anjakuchenbecker/mobile_smart_home_diy_camper_van/README.md

# "Mobile Smart Home" for our DIY Camper Van

With this repo I provide my concepts and some code snippets (example sketches) about our DIY camper van (Mercedes Sprinter W906; L4H2) that I will turn into a "Mobile Smart Home" with an Arduino Mega and a bunch of electronic components.
Besides the Arduino Mega I plan in addition to install a Raspberry PI with a nice touch screen which communicates with the Arduino Mega.

Check out also our [DIY Selbstausbau Blog & Vlog Camper Renntransporter](https://trackdates.de/howto/renntransporter/).

Example sketches can be found here: [Example Sketches](#example-sketches) 

## Table of Contents

- [Project Status](#project-status)
- [Planning and Overview](#planning-and-overview)
- [Features](#features)
- [Integration of the following hardware components](#integration-of-the-following-hardware-components)
- [Project Management](#project-management)
- [Overall Prototyping Status](#overall-prototyping-status)
- [Control Units](#control-units)
  - [Prototype Control Unit Sideboard](#prototype-control-unit-sideboard)
  - [Prototype Control Unit Bedroom](#prototype-control-unit-bedroom)
- [Storyboard Display](#storyboard-display)
  - [Display Implementation](#display-implementation)
- [Lighting Control Concept](#lighting-control-concept)
- [Example Sketches](#example-sketches)

## Project Status

**October 2021:**
Even if the final installation has been completed, I took a small improvement with respect to the illumination of the control units. 

I first used a round type red LED, but this wasn't bright enough. Reading the labels in the dark wasn't easy... so I switched over to a very, very small cold white SMD LED (mounting form 0805). Now I'm entirely happy! Have a look at the result:

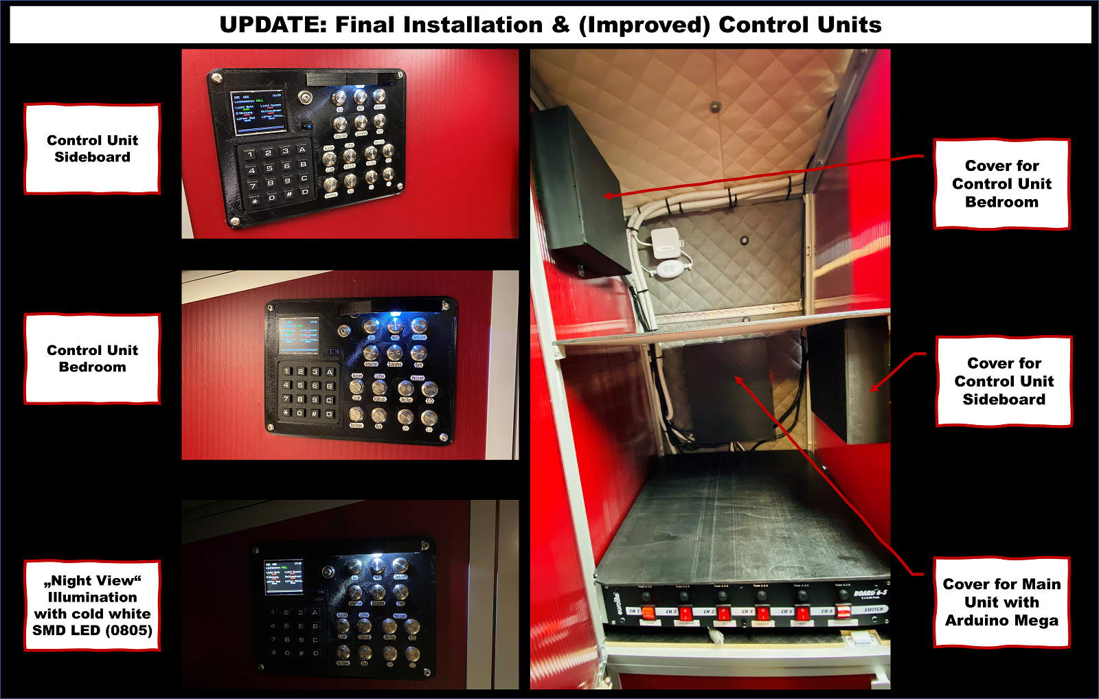
[picture p1: docs/mobile_smart_home_diy_camper_van_update_final_installation_and_improved_control_units.png]


**September 2021:**
Final installation is completed! I've build the final units (yes, a lot of more soldering and special thanks to our 3D Printer), installed all electronis components and wires (didn't measure the entire wire length, but this step took several weekends for completion) and adapted my code. 

Especially, handling the well-known issue with the distance sensors, when there is a lot of sun light. But with a little bit of math and statistics: now it works like a charm ;-)

More details are coming, we'll create a dedicated youtube video about the making of and the final installation and units.
For now, here is an impression about the final installation and the look of the final control units:

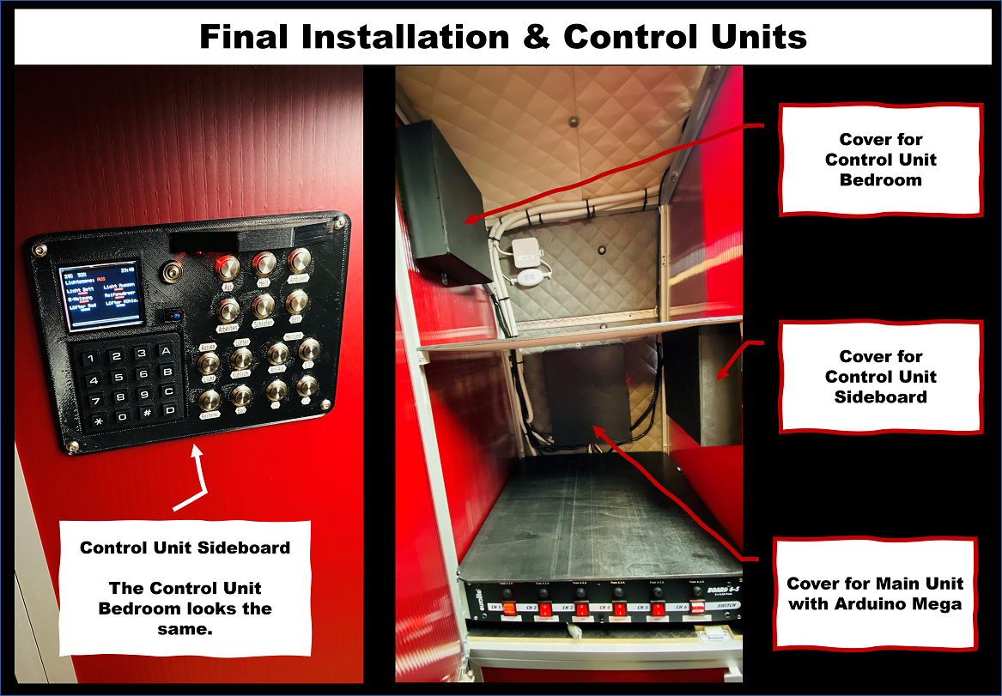
[picture p2: docs/mobile_smart_home_diy_camper_van_final_installation_and_control_units.png]


**June 2021:**
Prototyping is completed! I've soldered a lot, physically installed all of the electronic components and wrote over 4500 lines of code. Next step is to transform this prototype setup into final units, which can I install into our Sprinter.

## Planning and Overview

I've planned to install a bunch of components in the different areas within our Sprinter

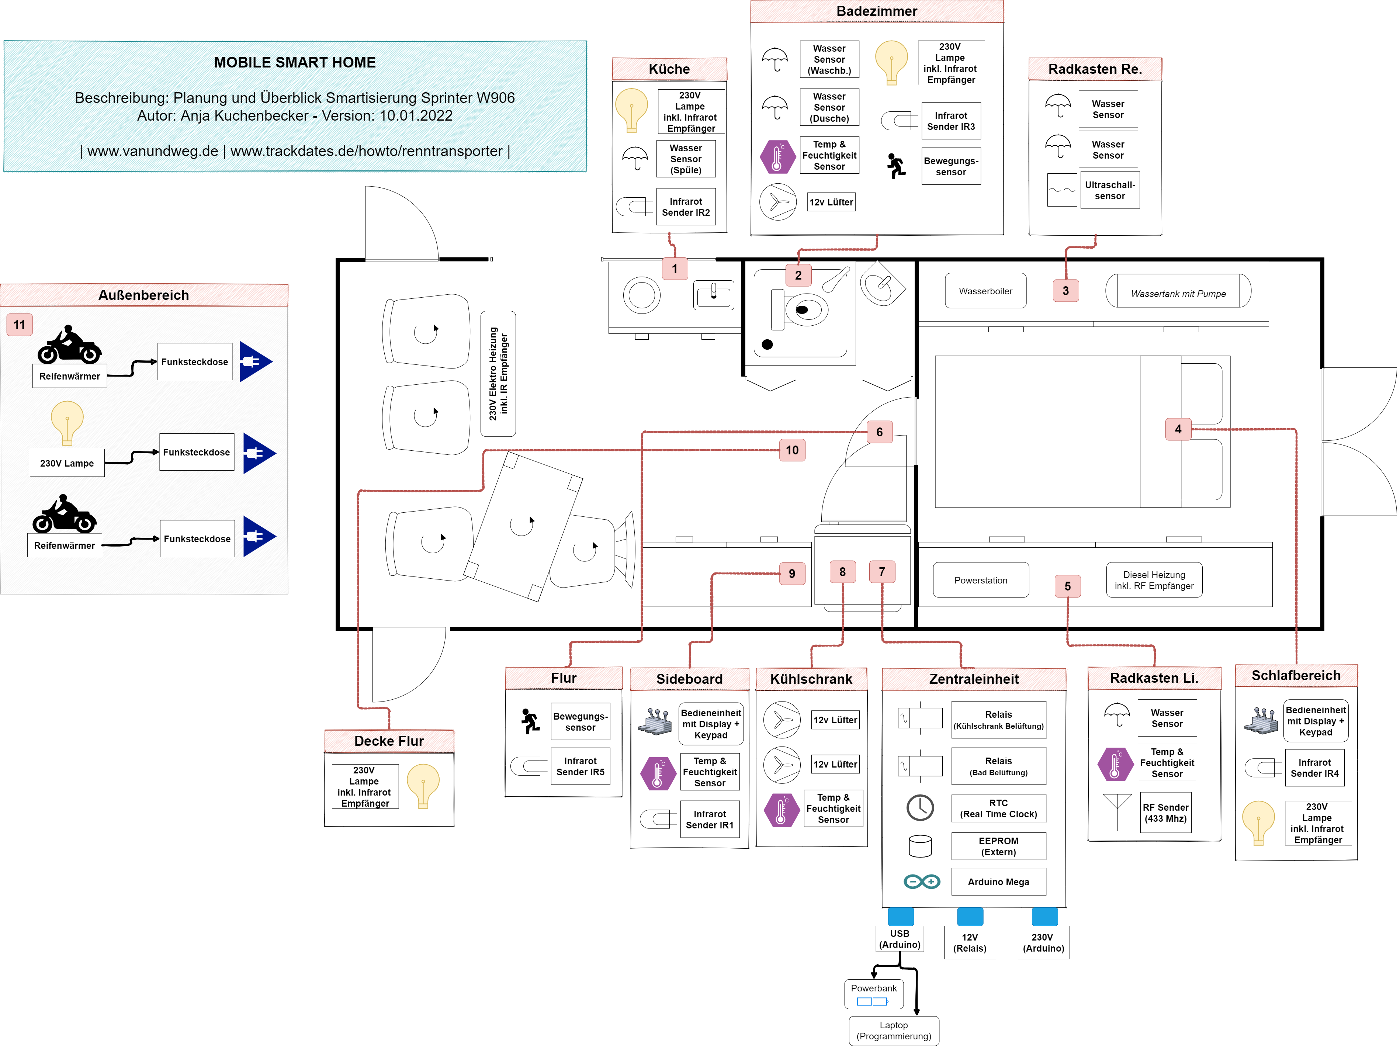
[picture p3: docs/mobile_smart_home_diy_camper_van_planning_overview.png]
Planning and Overview Diagram


## Features

The main features of self-made "Mobile Smart Home" solution are as follows

- Creation of two control units, which replace the handling different IR / RF vendor remote controls. One within the sideboard area the other one within the bedroom area, which offers the following means
  - Turn outside light on or off
  - Turn tire warmers on or off
  - Activation of five different light scenes (please refer to [Lighting Control Concept](#lighting-control-concept))
    - "Off": Turns all lights off (motion based triggered bathroom light excluded)
    - "Bright": Turns all lights on with maximum brightness level (motion based triggered bathroom light excluded)
    - "Ambient": Turns all lights on with low brightness level, orange light (motion based triggered bathroom light excluded)
    - "Work": Turns all lights on with medium brightness level, white light
    - "Sleep": Activates motion detector in corridor area. When motion is detected one light is activated in red color on lowest brightness level and the bathroom light is switched to red color in lowest brightness level when within the bathroom area a motion is detected.
  - Turn bedroom light on or off (separately despite the current enabled light scene)
  - Switch between electric heater and diesel heater control
  - Turn (electric or diesel) heater on or off
  - Increase or decrease of (electric or diesel) heater temperature
  - Touch area to switch between the different display states (please refer to [Storyboard Display](#storyboard-display))
    - [Default Screen](#default-screen-implementation)
    - [Water ingress status Screen](#water-ingress-status-screen-implementation)
    - [Climate status Screen](#climate-status-screen-implementation)
    - [Tire Warmers Timer](#tire-warmers-timer-implementation)
    - [Time and Date Setting](#time-and-date-setting-implementation)
    - [System Settings](#system-settings-implementation)
      - [Light Duration Configuration](#light-duration-configuration-implementation)
      - [Fridge Fan Temperature Threshold Configuration](#fridge-fan-temperature-threshold-configuration-implementation)
      - [Bathroom Fan Humidity Threshold Configuration](#bathroom-fan-humidity-threshold-configuration-implementation)
      - [Water Sensor Threshold Configuration](#water-sensor-threshold-configuration-implementation)
      - [Sideboard Distance Threshold Configuration](#sideboard-distance-threshold-configuration-implementation)
      - [Sideboard Touch Threshold Configuration](#sideboard-touch-threshold-configuration-implementation)
      - [Bed Distance Threshold Configuration](#bed-distance-threshold-configuration-implementation)
      - [Bed Touch Threshold Configuration](#bed-touch-threshold-configuration-implementation)
  - Control unit is illuminated automatically as well as display is turned on for a specific duration in case of your hand comes near the control unit
  - Display is turned on for a specific duration in case of touch or button push is detected
  - You can set a timer when the tire warmers should be turned on (only via control unit sideboard)
  - You can set date and time (only via control unit sideboard)
- Bathroom light turns on automatically for a specific duration in case of motion is detected (color and brightness level depends on currently activated light scene)
- Bathroom fan turns on automatically in case of specific humidity threshold overrun is detected
  - Behavior can be overruled by permanently on and off mode
- Fans located in fridge closet turn on automatically in case of specific temperature threshold overrun is detected
  - Behavior can be overruled by permanently on and off mode
- Water tank level monitoring
- Water ingress level monitoring
- Temperature and humidity monitoring
- Change of system configuration parameters
  - LED and background light duration of control units
  - Temperature threshold for fridge fans
  - Humidity threshold for bathroom fan
  - Water ingress threshold for water sensors
  - Distance recognition threshold for sideboard control unit
  - Touch recognition threshold for sideboard control unit 
  - Distance recognition threshold for bed control unit
  - Touch recognition threshold for bed control unit 
- Permanently storage of system configuration parameters
- Pluggable main unit ("Zentraleinheit"): One the one hand the main unit can be easily put out during winter time, when our Sprinter is not in use. On the other hand it can be easily put in temporary, also during winter time, to check if there are no issues (e.g., water ingress) operated with the support of a USB power bank.

## Integration of the following hardware components 

Total: 116 components
- Arduino Mega 2560 compatible microcontroller board (1 piece; ELEGOO Mega2560 R3)
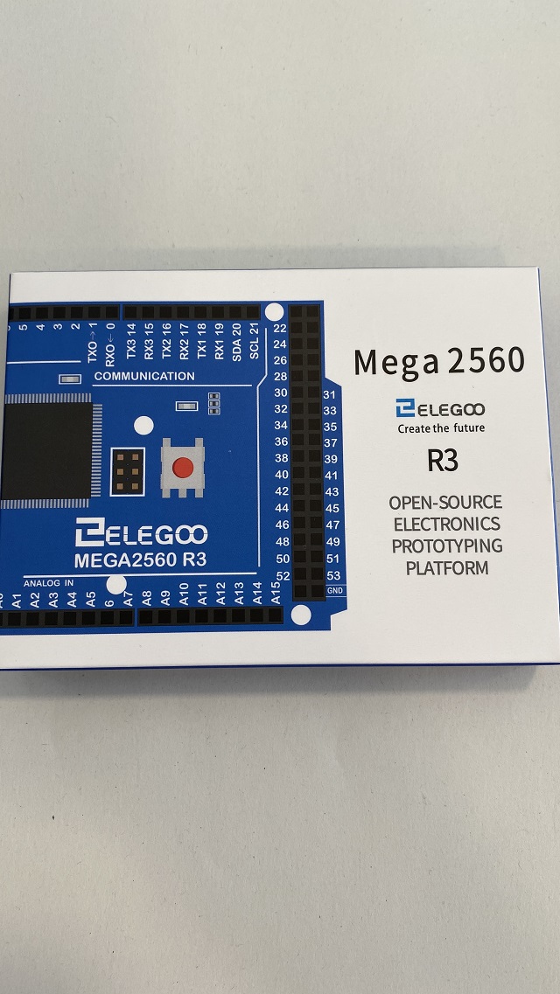
[picture p4: components/elegoo_mega_2560_r3.jpg]
  -   
- Screw / Terminal Block Shield Board Kit For ArduinoMEGA-2560 R3
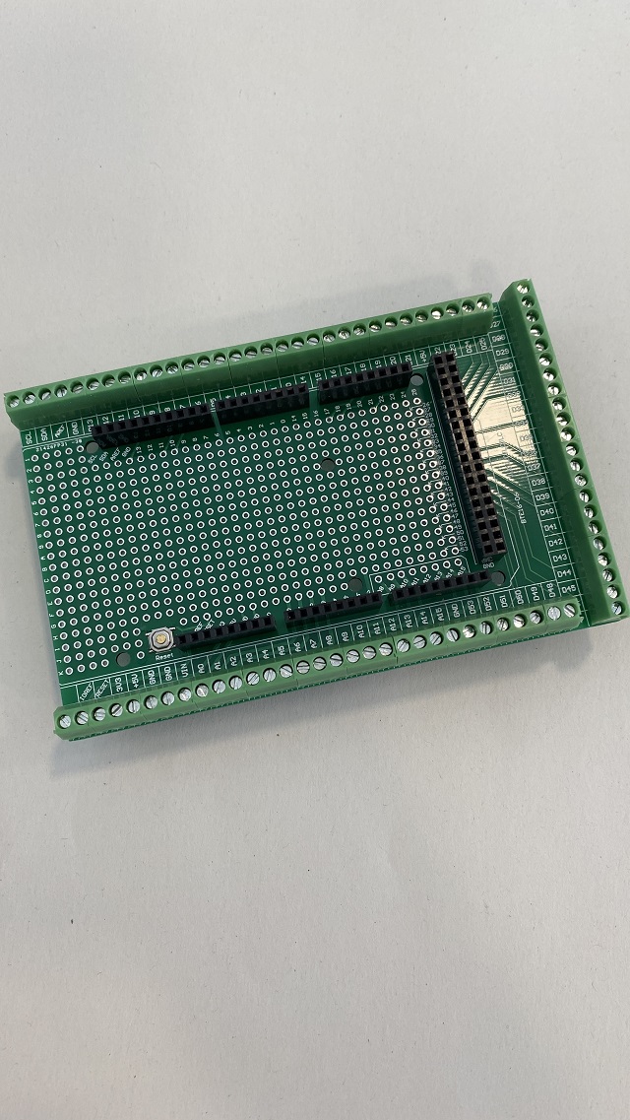
[picture p5: components/screw_terminal_block_shield_board_kit_arduino_mega.jpg]
  -   
- 230V lights (4 pieces) with IR remote control from different vendors (e.g., iDual)
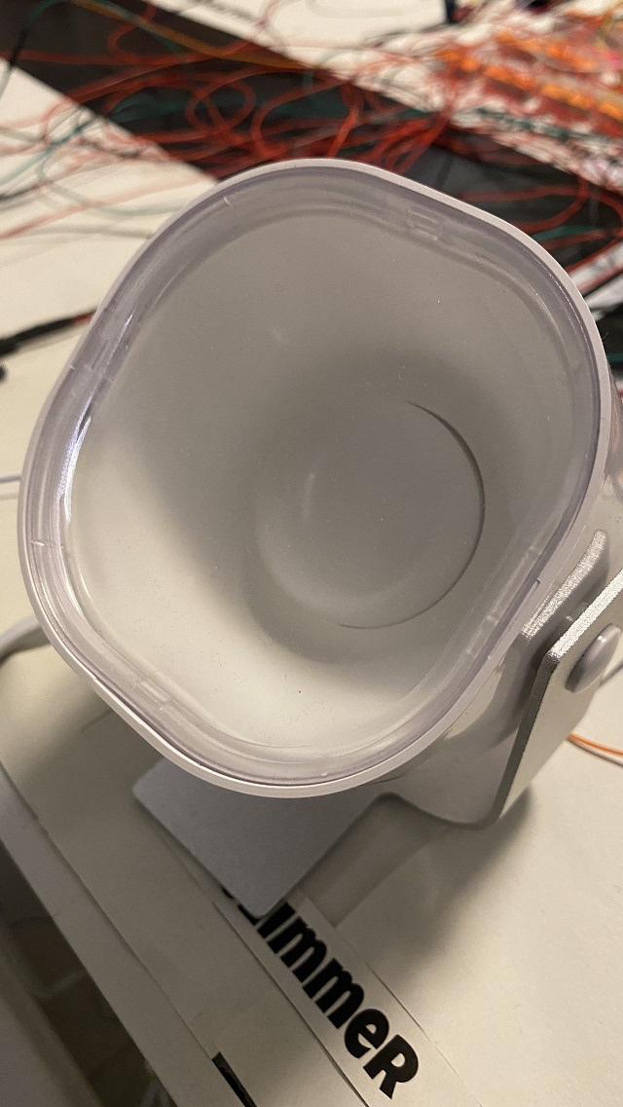
[picture p6: components/iDual_led_projektor_eek_front.jpg]
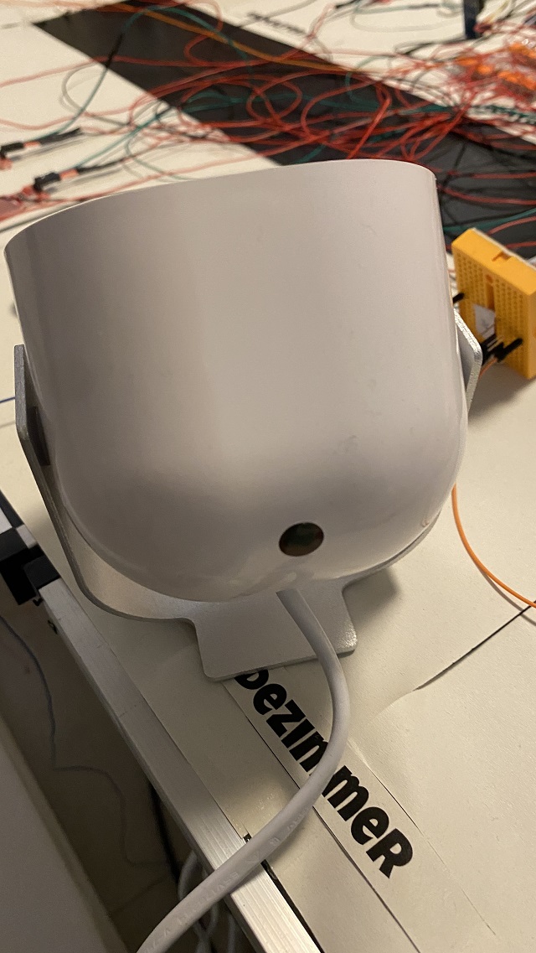
[picture p7: components/iDual_led_projektor_eek_back.jpg]
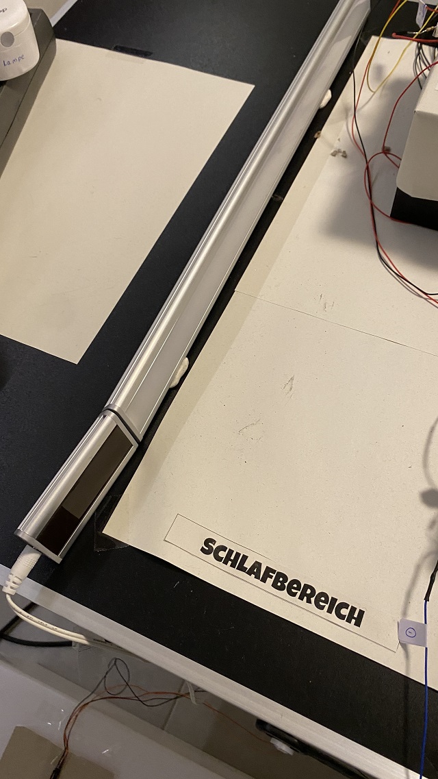
[picture p8: components/iDual_led_udo.jpg]
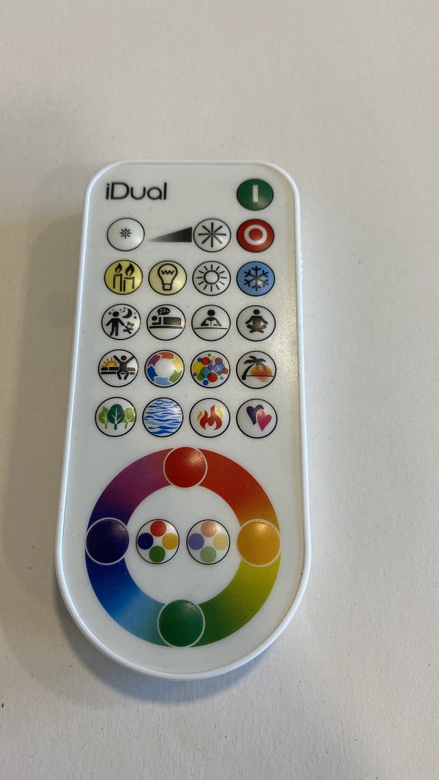
[picture p9: components/iDual_remote_control.jpg]
  - 
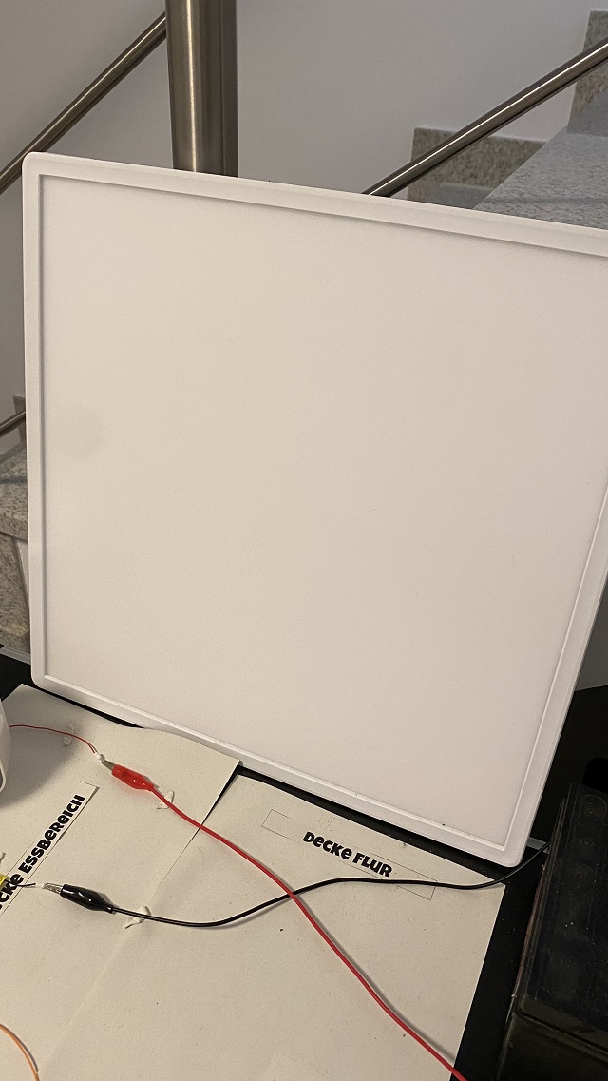
[picture p10: components/LED_ceiling_light.jpg]
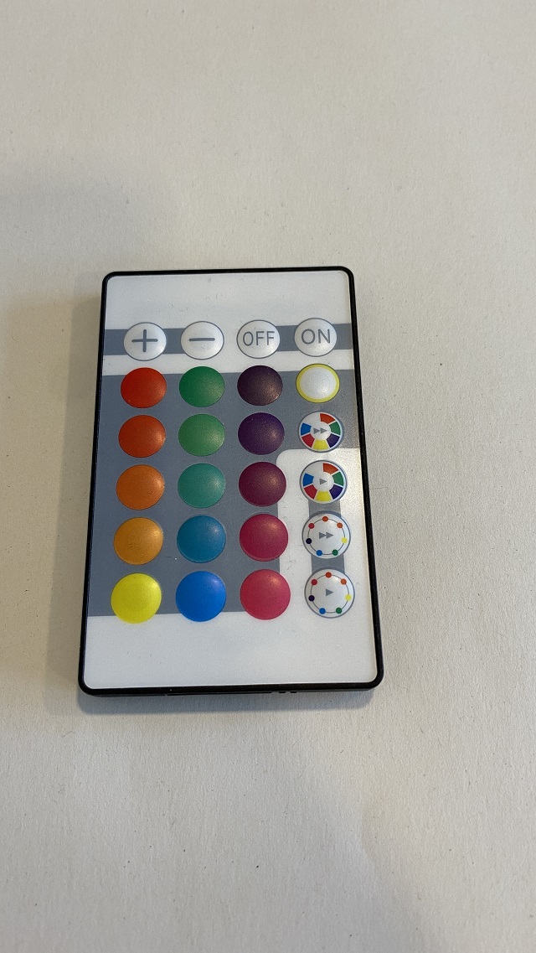
[picture p11: components/LED_ceiling_light_remote_control.jpg]
  - 
- 230V electric heater with IR remote control
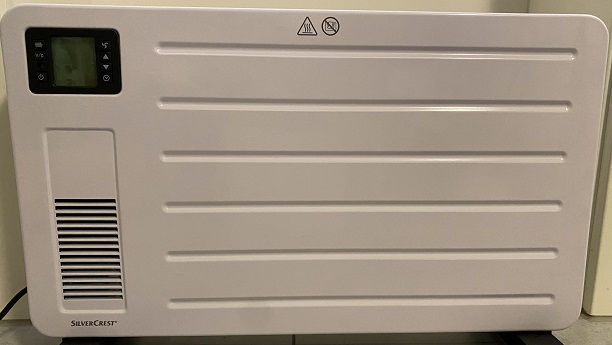
[picture p12: components/230_v_electric heater.jpg]
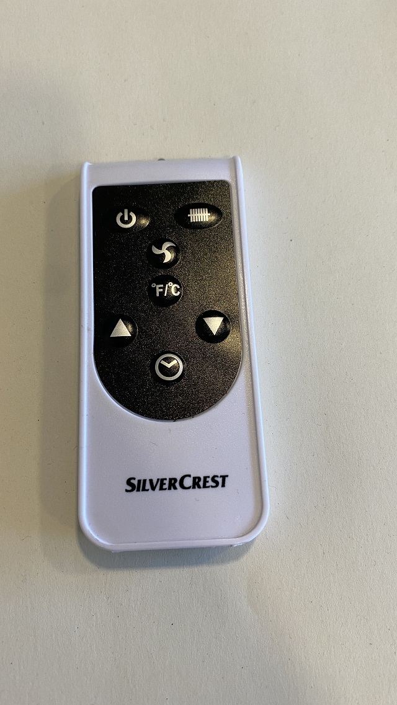
[picture p13: components/230_v_electric heater_remote_control.jpg]
  -   
- 12V diesel heater with RF remote control
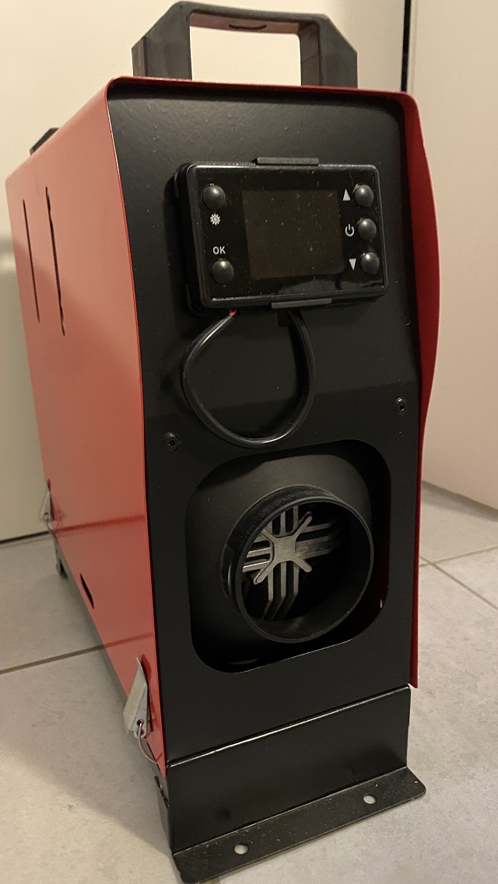
[picture p14: components/12_v_diesel_heater.jpg]
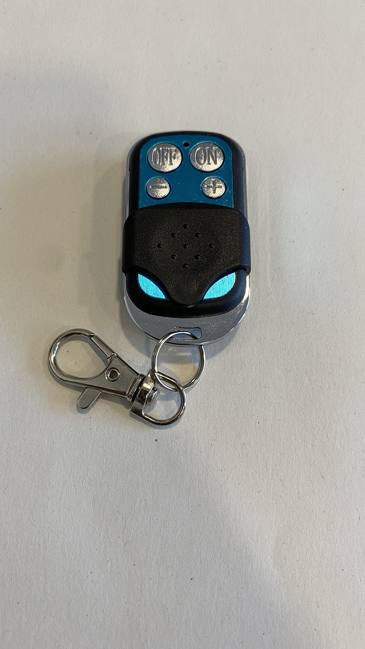
[picture p15: components/12_v_diesel_heater_remote_control.jpg]
  -   
- 230V RF sockets (2 pieces) with RF remote control
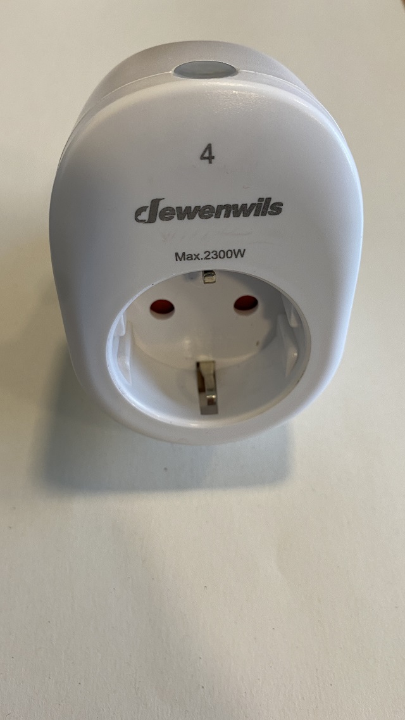
[picture p16: components/rf_plug_socket.jpg]
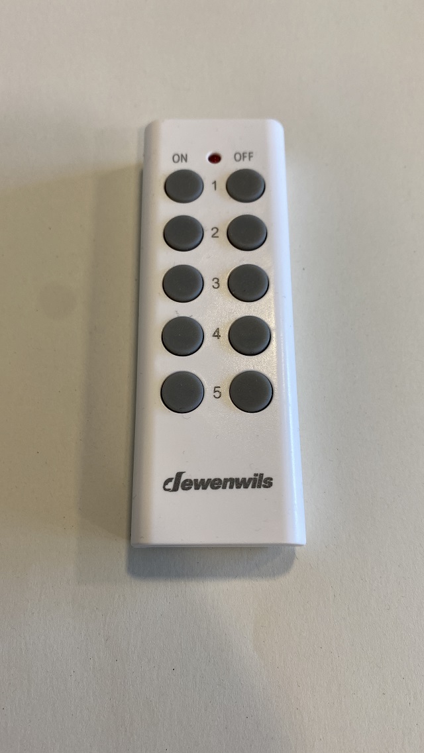
[picture p17: components/rf_plug_socket_remote_control.jpg]
  -  
- 80x80x25mm fan (1 piece; 12V, 76,4m^3/h, 38dBA)
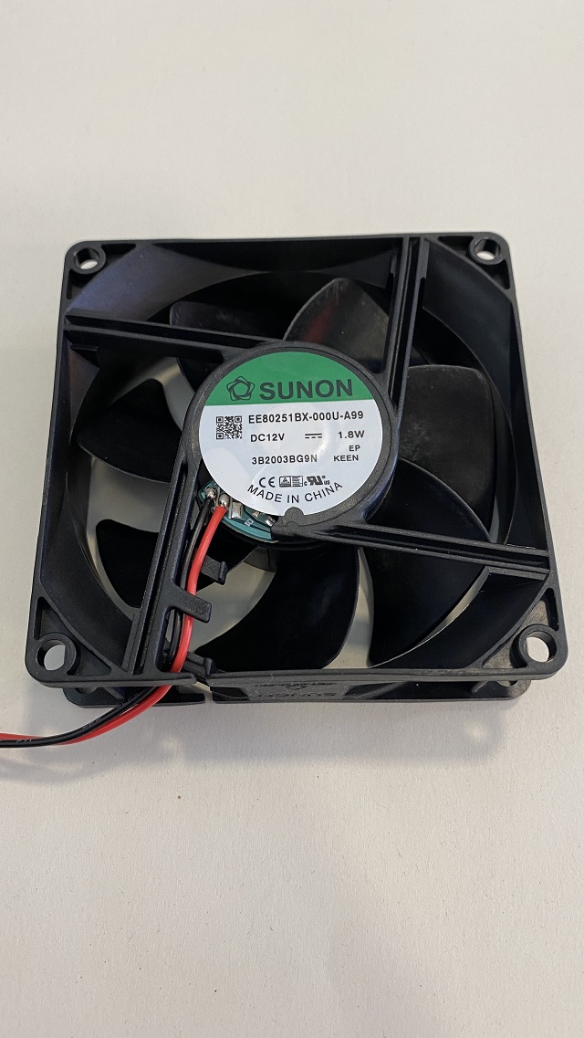
[picture p18: components/80_80_25_fan.jpg]
  -   
- 120x120x25mm fans (2 pieces; 12V, 127,3m^3/h, 34dBA)
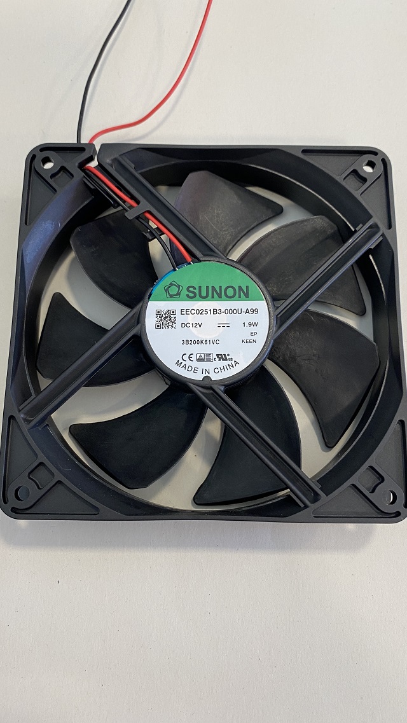
[picture p19: components/120_120_25_fan.jpg]
  -    
- Water Sensors (6 pieces; SE045)
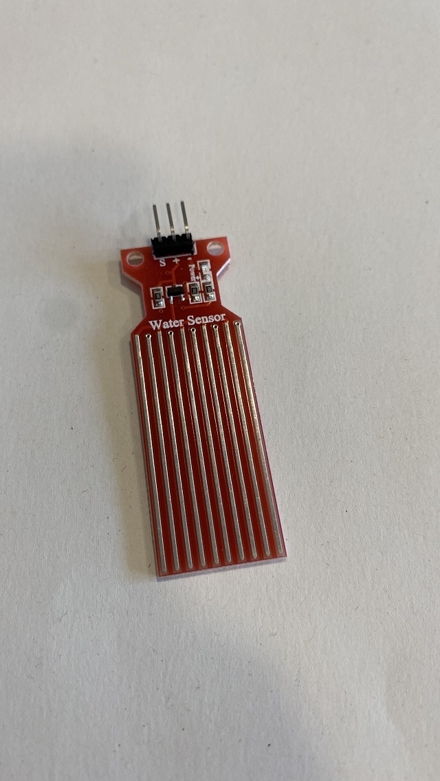
[picture p20: components/water_sensor_SE045.jpg]
  - 
- Ultrasonic sensor (1 piece; HC-SR04)
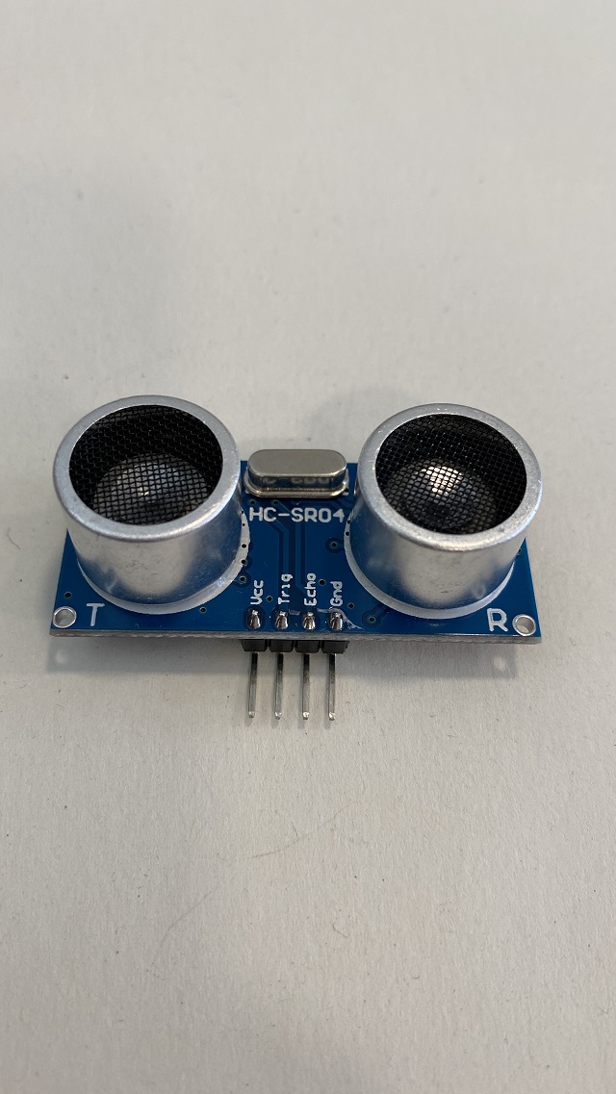
[picture p21: components/ultrasonic_sensor_hc_sr04.jpg]
  -   
- IR-Emitter (5 pieces; TSAL 6200 IR-Emitter 940nm)
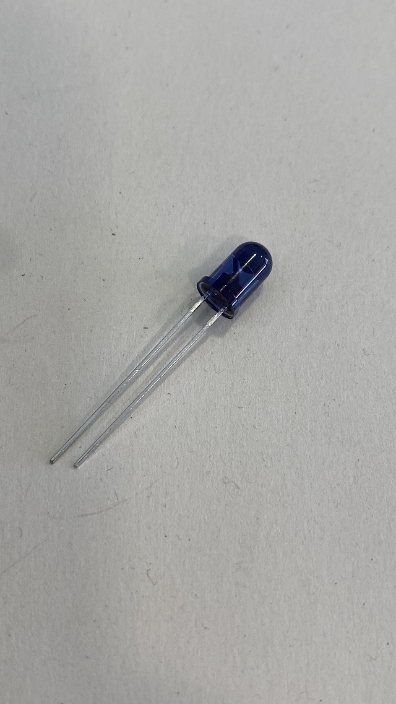
[picture p22: components/tsal_6200ir_emitter_940_nm.jpg]
  -  
- Motion Sensors (2 pieces; HC-SR501)
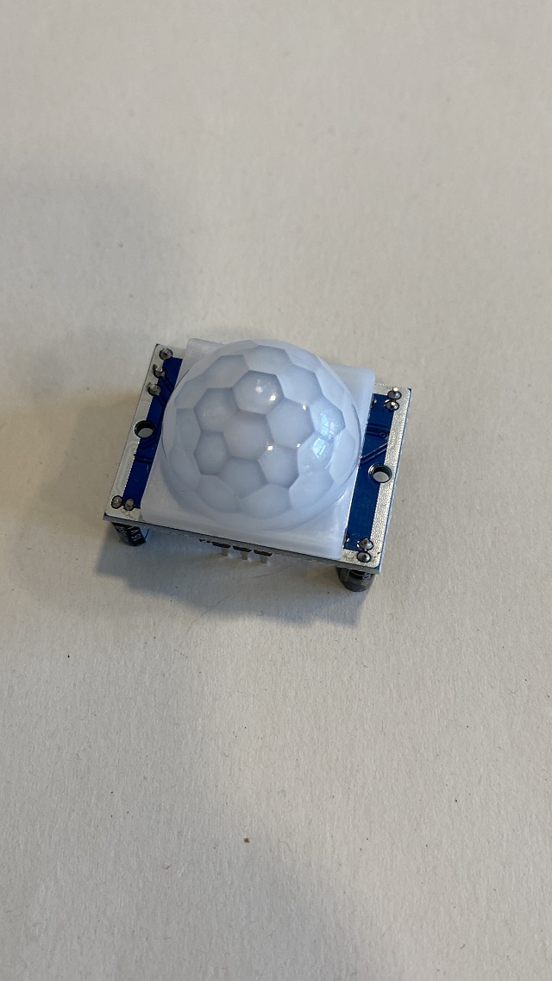
[picture p23: components/motion_sensor_HC-SR501_front.jpg]
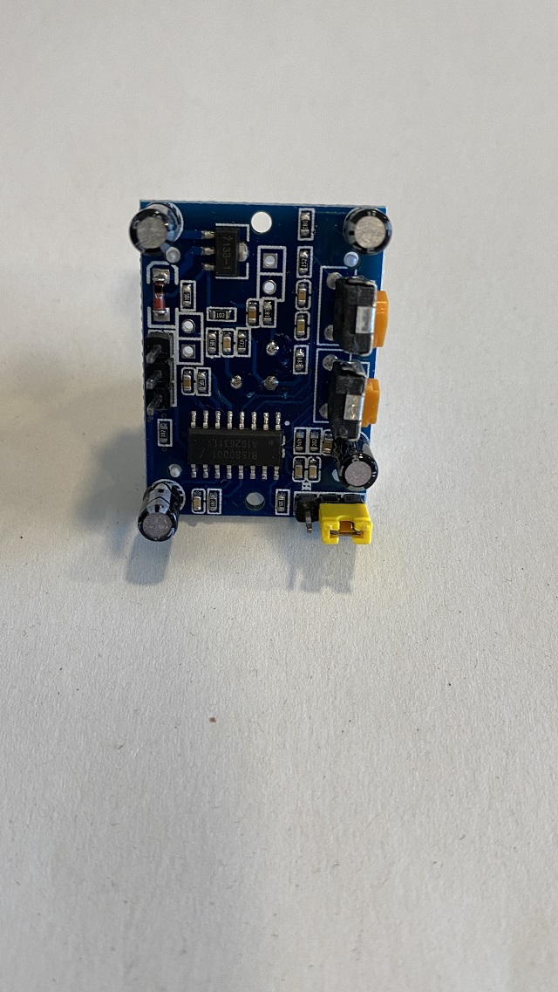
[picture p24: components/motion_sensor_HC-SR501_back.jpg]
  - 
- Temperature & Humidity Sensors (4 pieces; DHT22)
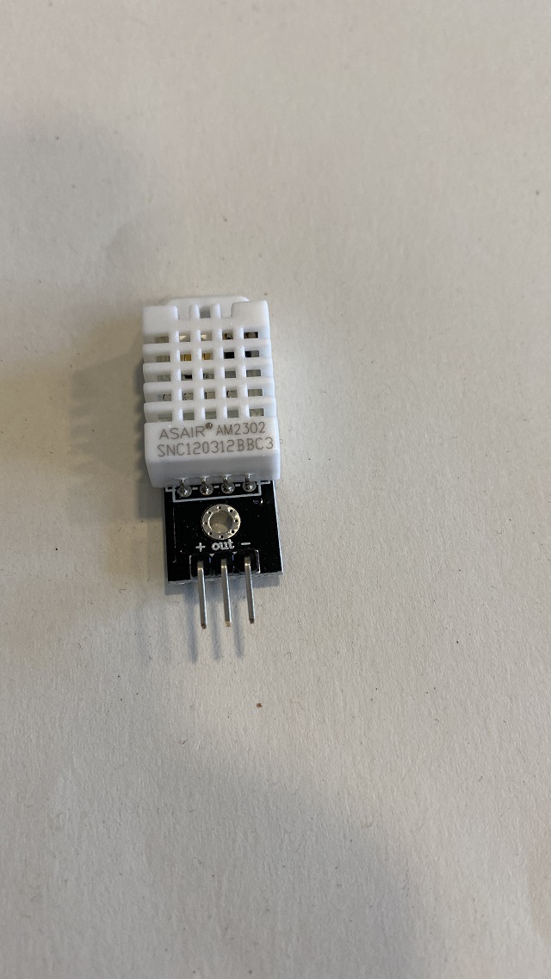
[picture p25: components/temperature_humidity_sensor_DHT22.jpg]
  -  
- TFT Displays (2 pieces; 1.8 Zoll SPI ST7735 TFT Display 128 x 160 Pixel)
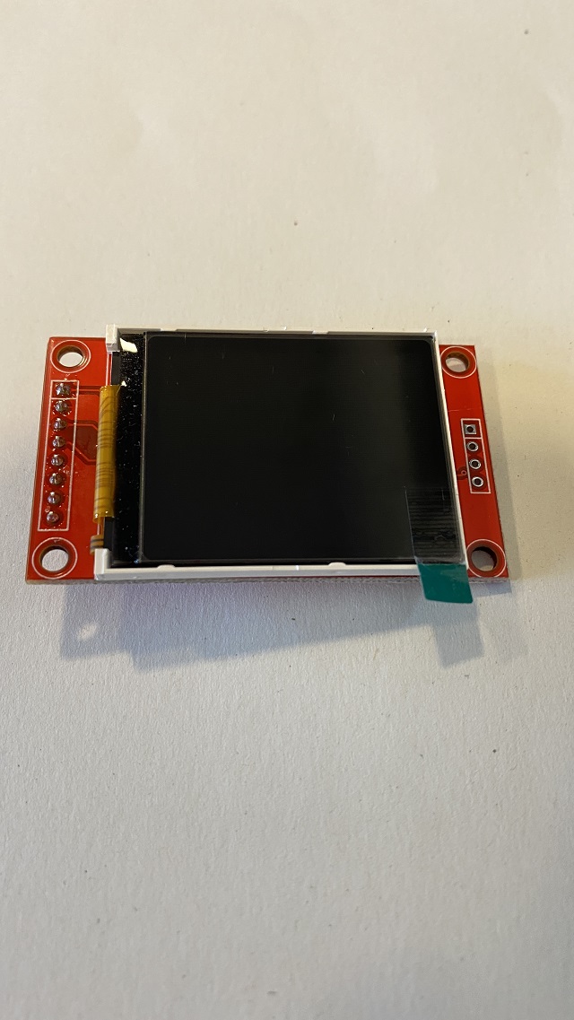
[picture p26: components/1-8_SPI_TFT_Display_ST7735_128x160_front.jpg]
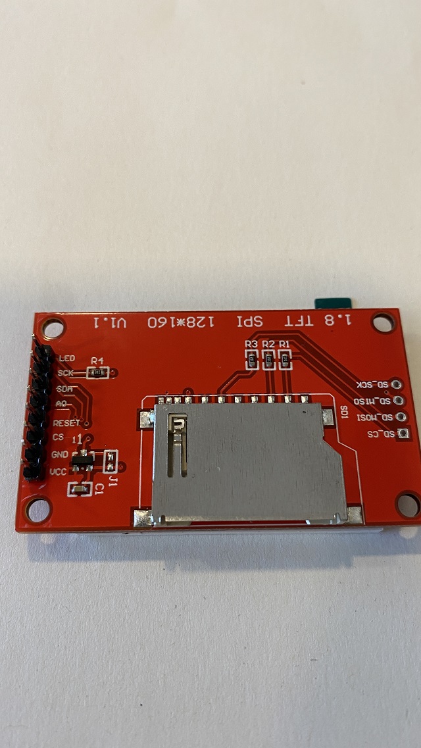
[picture p27: components/1-8_SPI_TFT_Display_ST7735_128x160_back.jpg]
  -   
- Line Follower IR Sensor (2 pieces; TCRT5000)
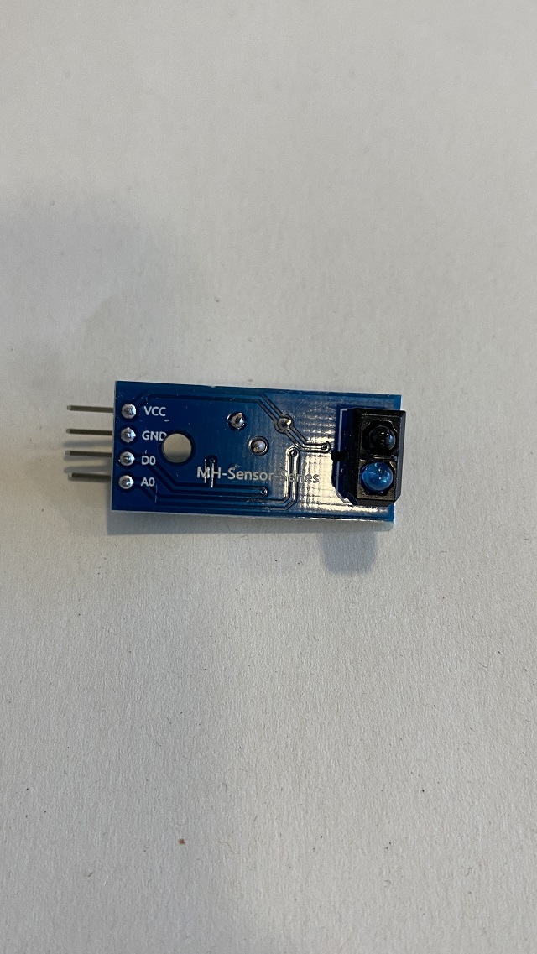
[picture p28: components/line_follower_ir_sensor_front.jpg]
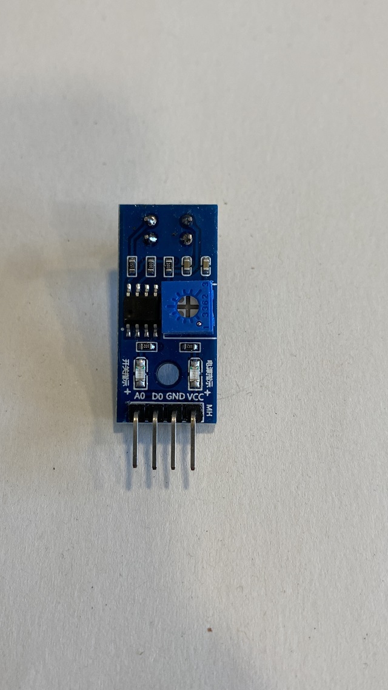
[picture p29: components/line_follower_ir_sensor_back.jpg]
  -    
- Shift registers (4 pieces; 74HC165)
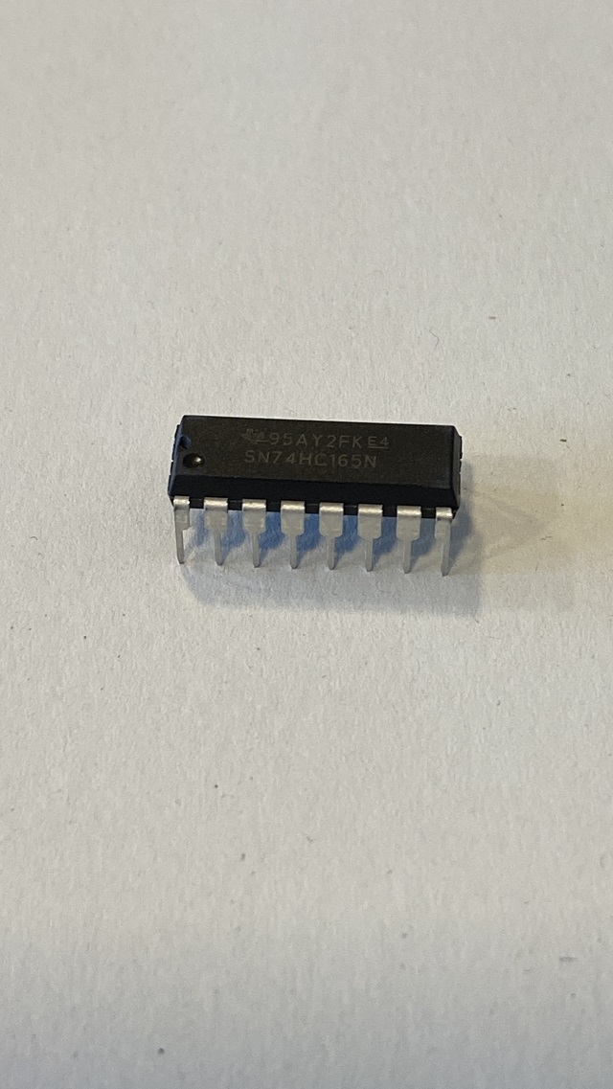
[picture p30: components/74HC165_shift_register.jpg]
  -  
- Real Time Clock (1 piece; DS3231)
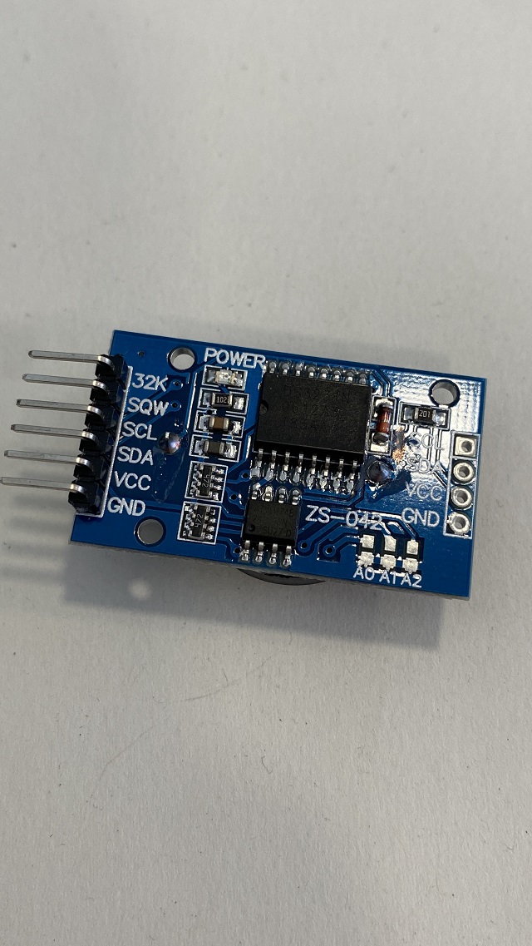
[picture p31: components/real_time_clock_rtc_DS3231_front.jpg]
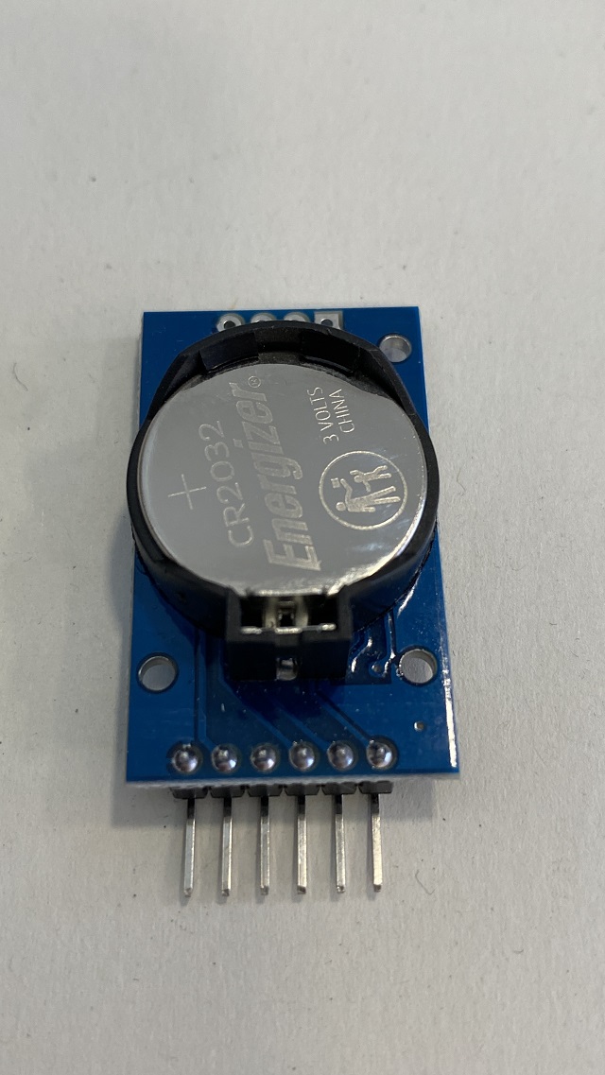
[picture p32: components/real_time_clock_rtc_DS3231_back.jpg]
  -  
- Relais Module (1 piece; 4-Relais Modul 5V)
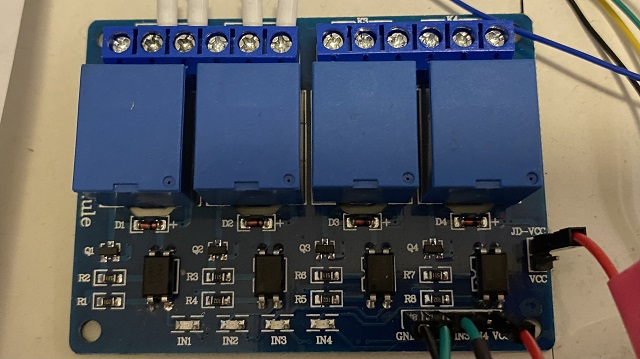
[picture p33: components/4_relais-modul 5_v.jpg]
  -  
- NPN-Transistor (1 piece; PN2222)
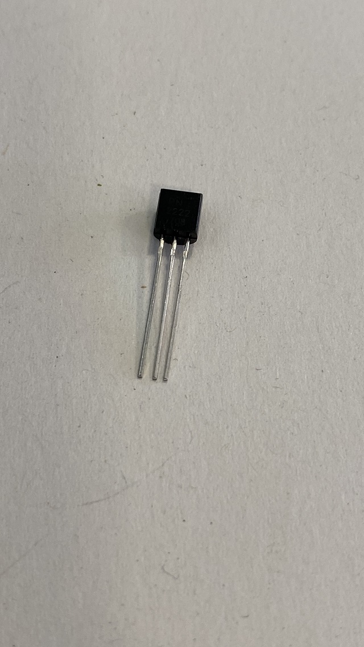
[picture p34: components/npn-transistor_pn2222.jpg]
  -  
- External EEPROM Module (1 piece; AT24C256 I2C Interface EEPROM)
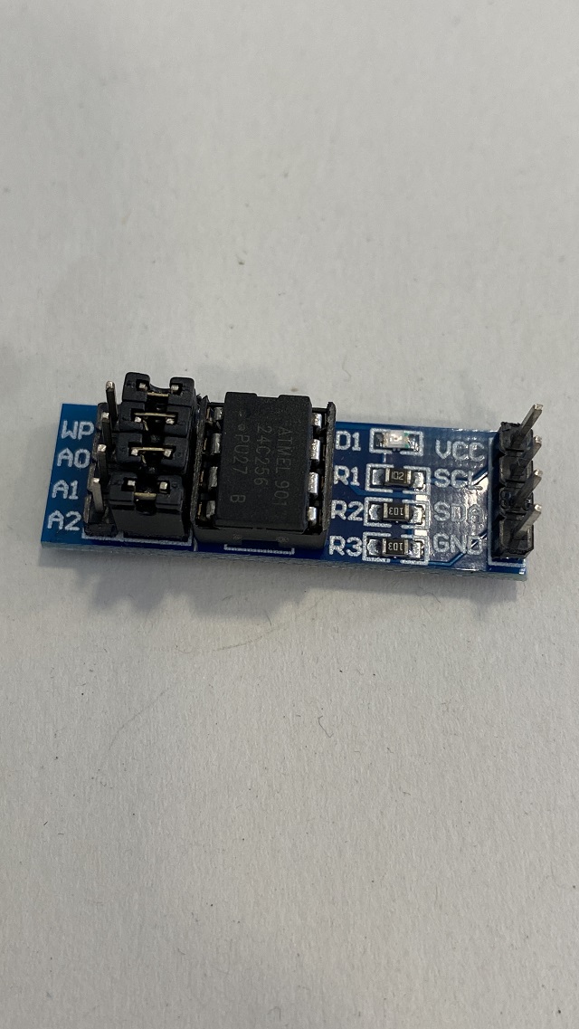
[picture p35: components/external_eeprom_at24c256_i2c_interface_eeprom.jpg]
  -  
- RF 433 MHz Transmitter (1 piece; H34A)
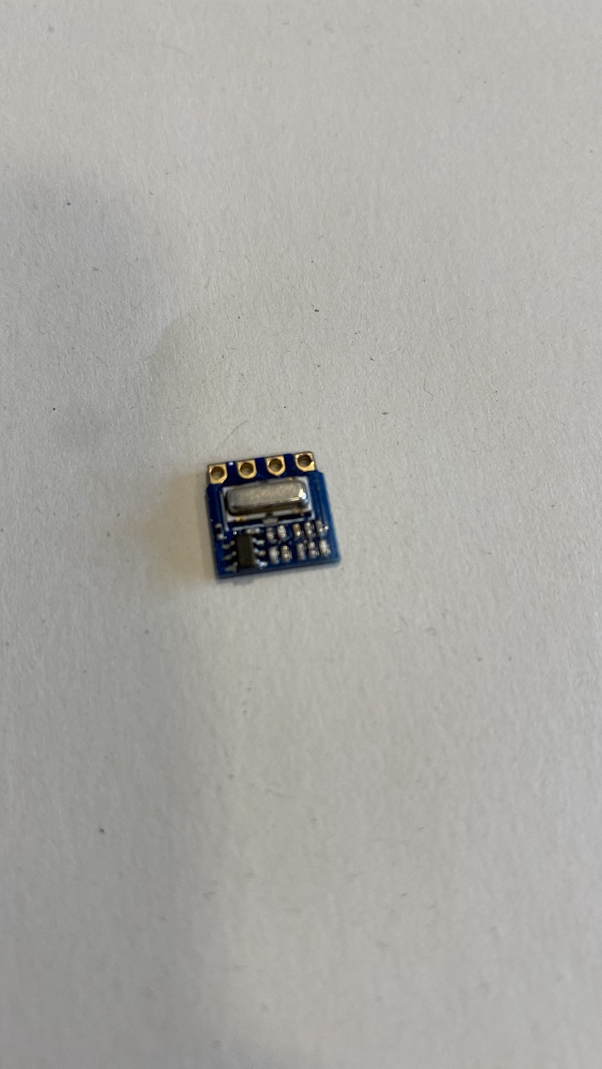
[picture p36: components/rf_433_mhz_transmitter_H34A_front.jpg]
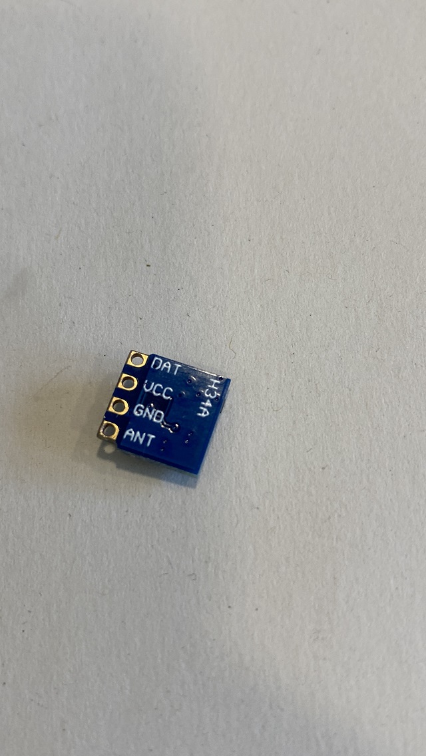
[picture p37: components/rf_433_mhz_transmitter_H34A_back.jpg]
  -   
- Momentary Push Buttons (28 pieces; 12mm)
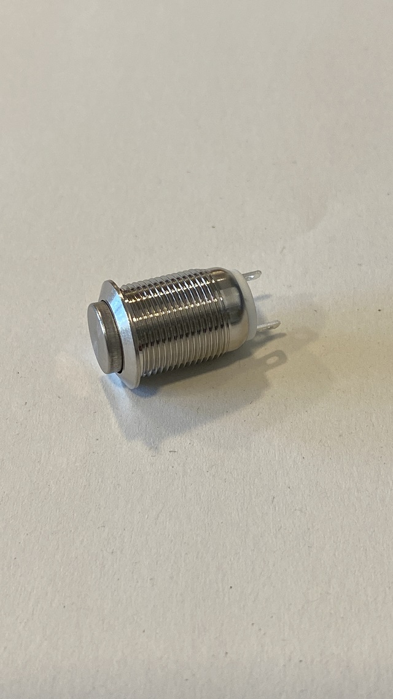
[picture p38: components/Momentary_Push_Button_12mm.jpg]
  -  
- 4x4 Matrix Keypad (2 pieces)
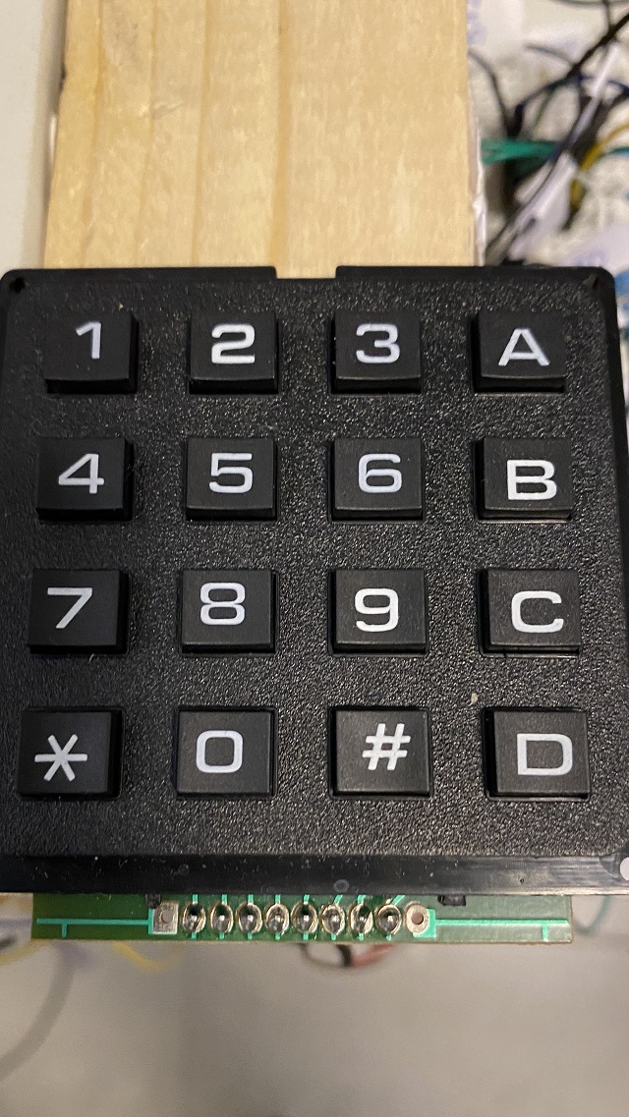
[picture p39: components/Matrix_Keypad_4x4.jpg]
  -  
- SMD LED cold white (2 pieces; mounting form 0805)
- Different resistors

## Project Management

For the management of this project I have set up a trello board (Kamil acts as tester as well as a requirements stakeholder like me):

Please note that I've blackened most of the story cards!

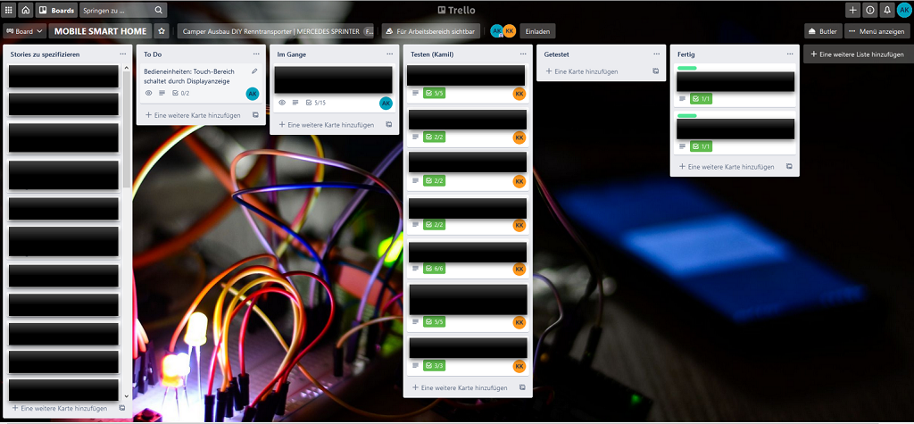
[picture p40: docs/mobile_smart_home_diy_camper_van_trello_board.png]
 

I have break down all requirements / stuff I have to build and implement in the course of this project into stories, here is an example story:

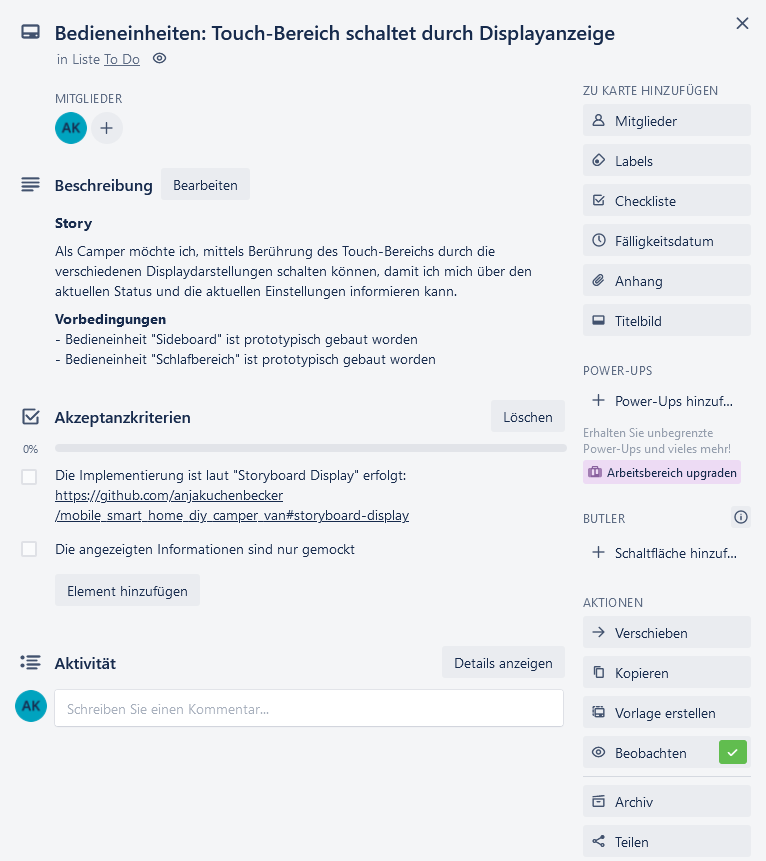
[picture p41: docs/mobile_smart_home_diy_camper_van_story_detail.png]
 

## Overall Prototyping Status

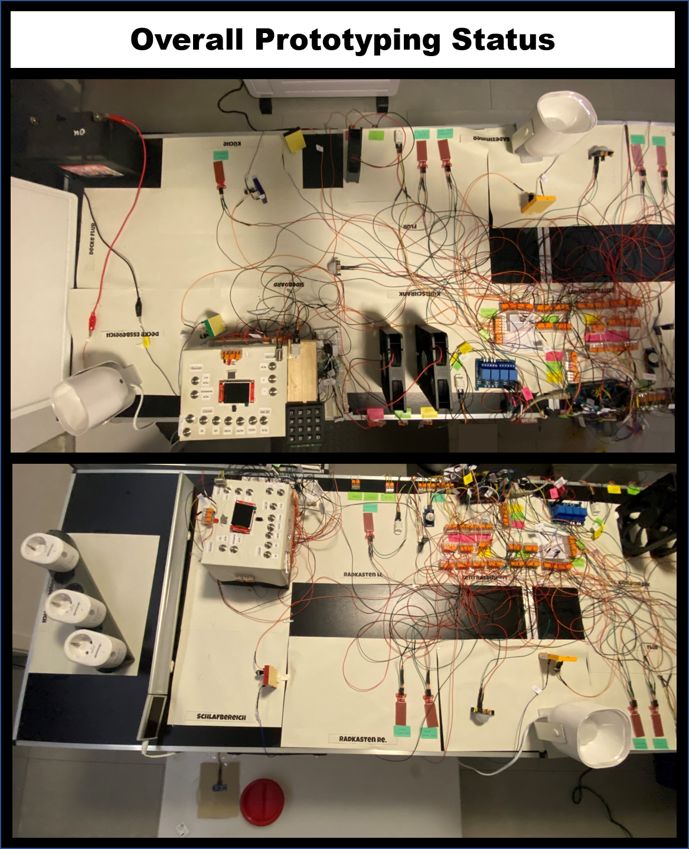
[picture p42: docs/mobile_smart_home_diy_camper_van_overall_prototyping_status.png]
 

## Control Units

I created a functional concept for the control units, that I plan to build for our Sprinter.

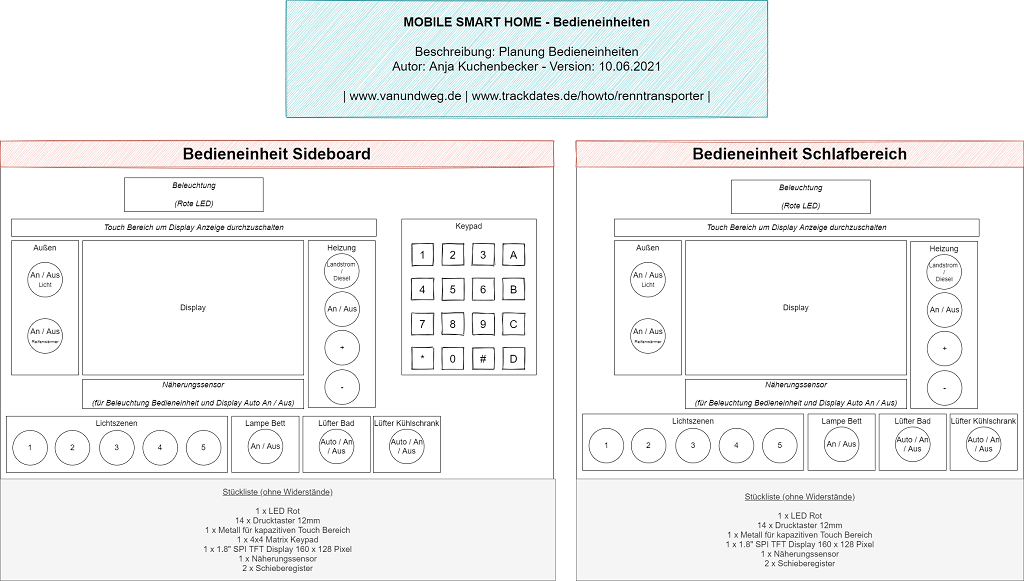
[picture p43: docs/mobile_smart_home_diy_camper_van_control_units.png]
Control Units Diagram


### Prototype Control Unit Sideboard

Current Prototype (only for testing purposes) and the creation process behind:

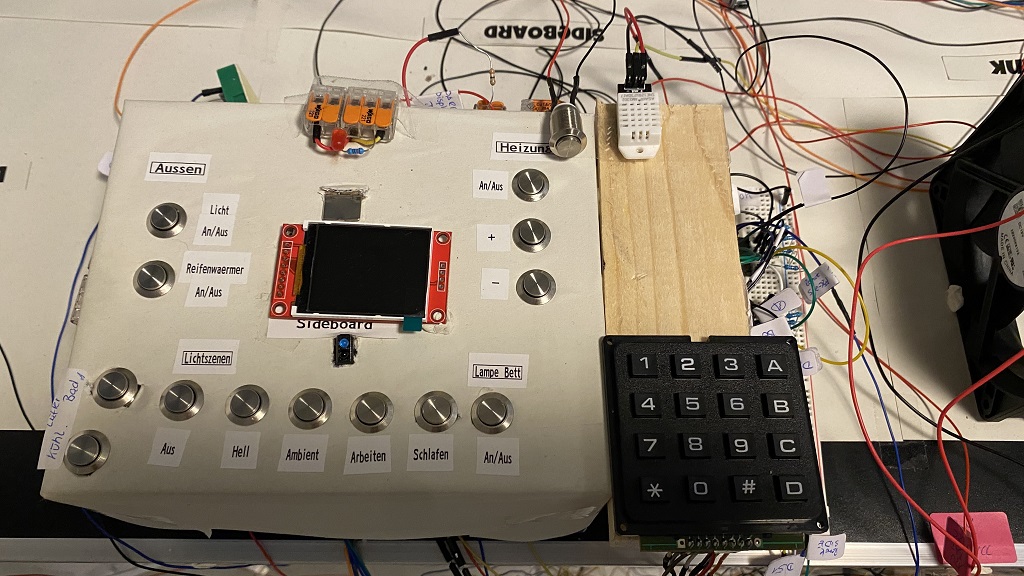
[picture p44: docs/mobile_smart_home_diy_camper_van_prototype_control_unit_sideboard.jpg]
 

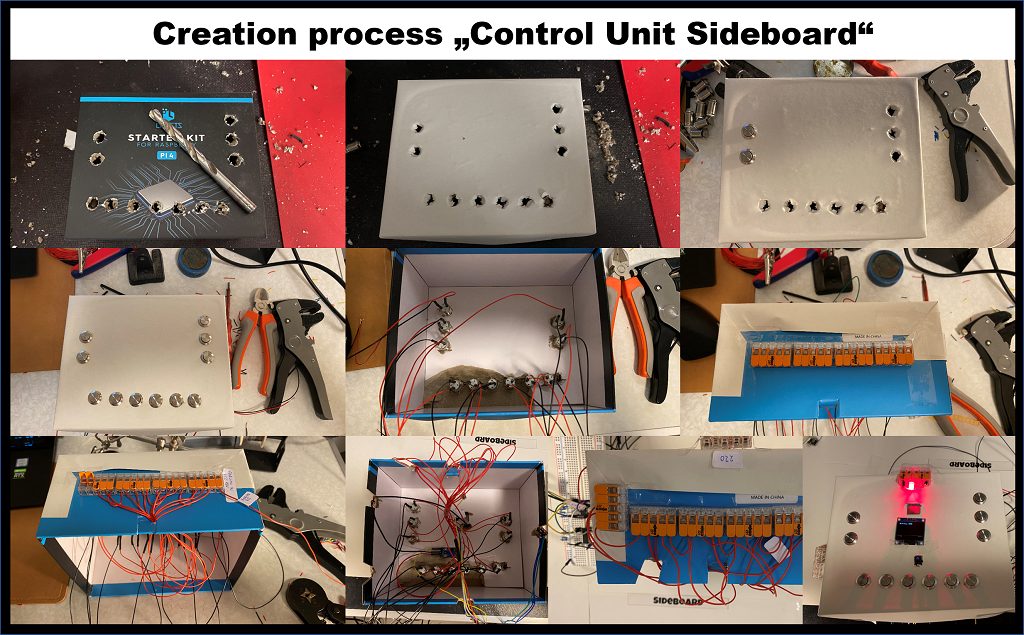
[picture p45: docs/mobile_smart_home_diy_camper_van_creation_process_control_unit_sideboard.png]
 

### Prototype Control Unit Bedroom

Current Prototype (only for testing purposes) and the creation process behind (same as for sideboard, therefore shortened):

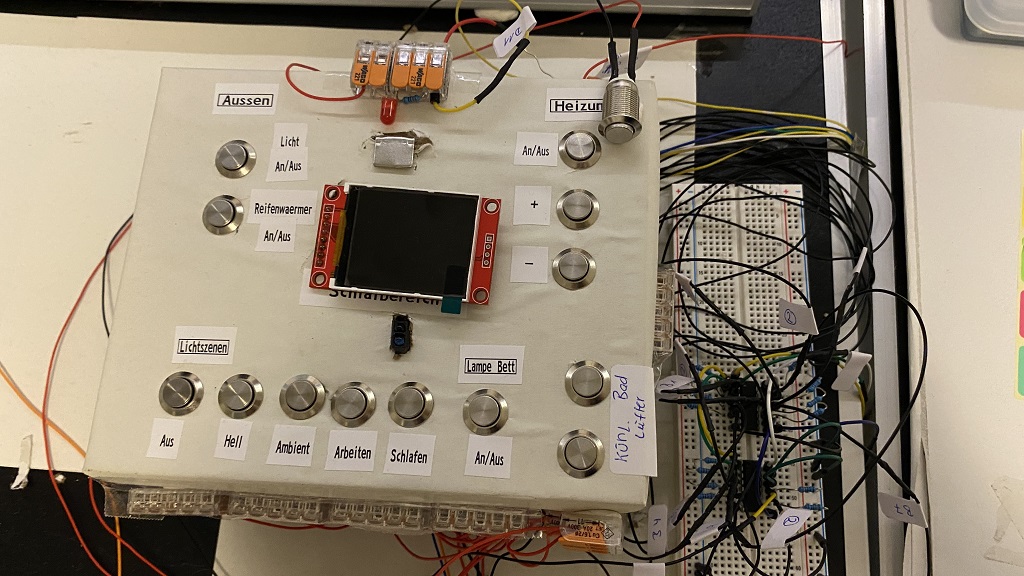
[picture p46: docs/mobile_smart_home_diy_camper_van_prototype_control_unit_bedroom.jpg]
 

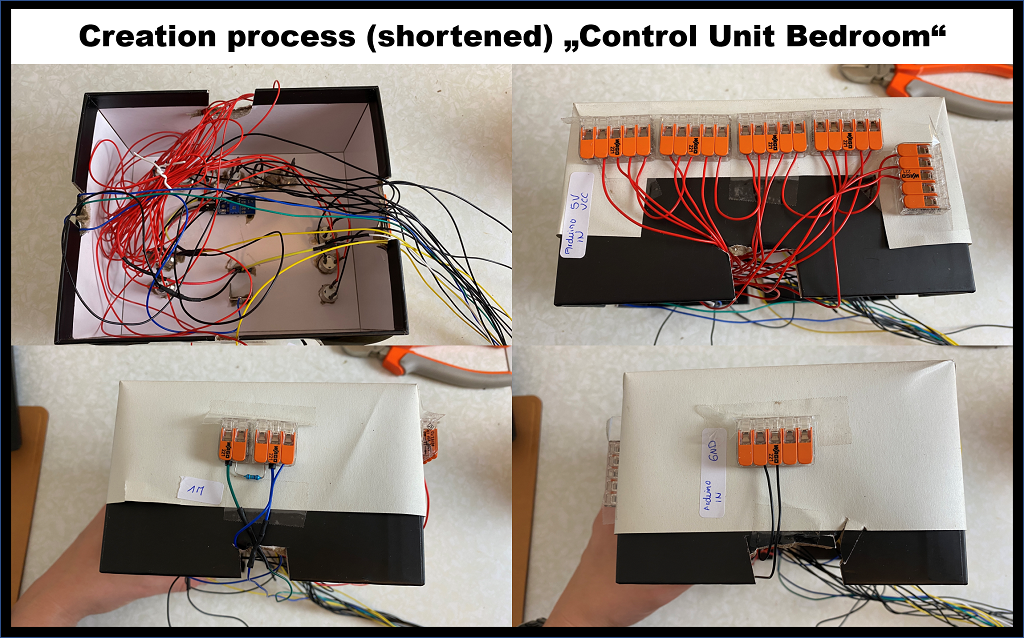
[picture p47: docs/mobile_smart_home_diy_camper_van_creation_process_control_unit_bedroom.png]
 

## Storyboard Display

Before I started with the display implementation I created a storyboard for the display content and UI-Workflow.
Please be aware that such a storyboard depicts not the final UI design. It should "only" represent which information should be displayed in which situation.

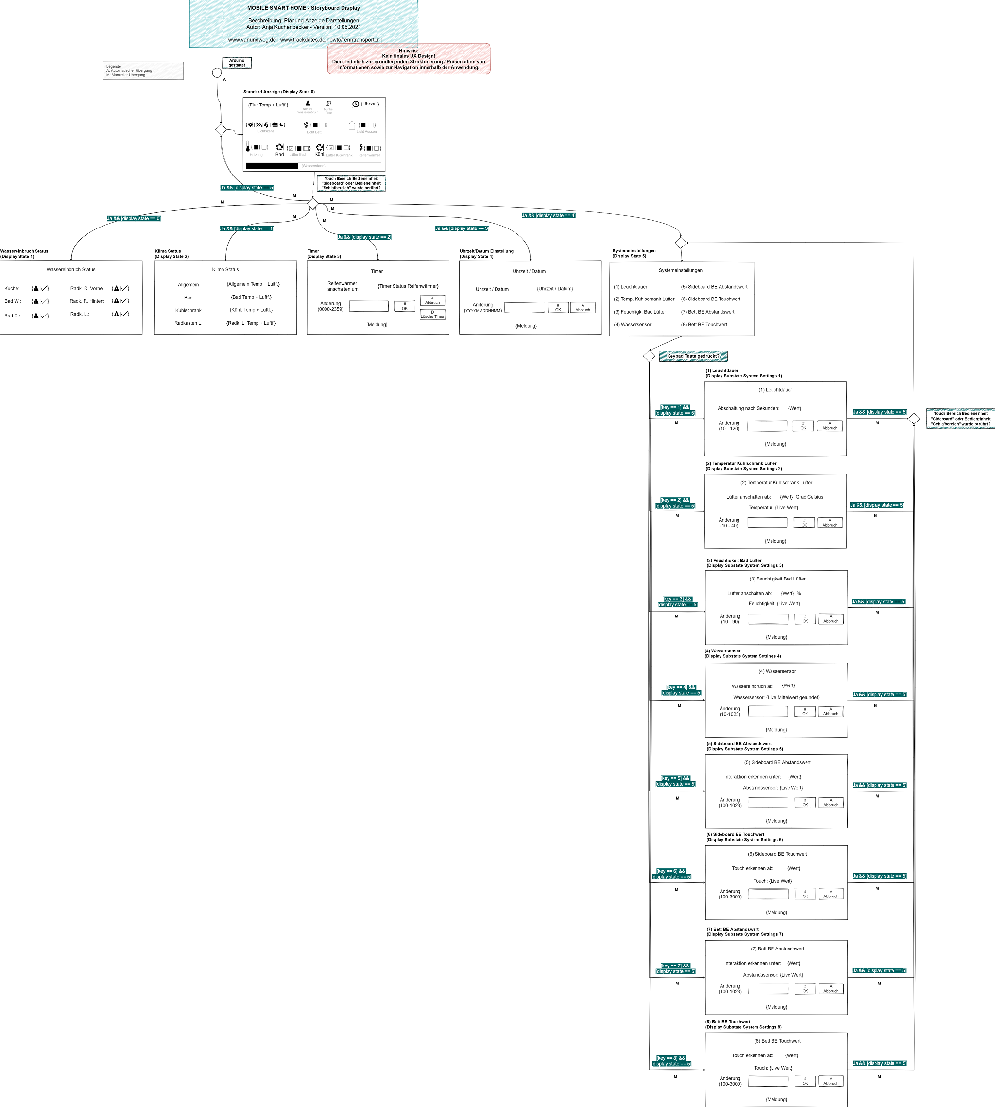
[picture p48: docs/mobile_smart_home_diy_camper_van_storyboard_display.png]
Storyboard Display


### Display Implementation

According to my storyboard concept, I implemented the screens and screen workflow.
By usage of the touch area, you switch between the six main screens as they are depicted in the following screenshots. Some screens enables the possiblity to enter values and perform actions via the keypad. In the "System Settings" screen you can go to a specific setting by hitting the related key on the keypad.

#### Default Screen Implementation

The default screen shows the following information
- Current main temperature and humidity
- Current time
- Tire warmers timer indicator (only if timer has been set)
- Overall water ingress status level indicator (only if at least one water ingress threshold is exceeded)
- Currently selected light screne ("AUS", "HELL", "AMBIENT", "ARBEITEN", "SCHLAFEN" )
- Bed light status indicator (green: on; red: off)
- Outside light indicator (green: on; red: off)
- Currently selected heater ("E-Heizung" or "D-Heizung)
- Heater status indicator (green: on; red: off)
- Tire warmers indicator (green: on; red: off)
- Bathroom fan indicator (grey: auto mode; green: permanently on; red: permanently off)
- Fridge closet fans indicator (grey: auto mode; green: permanently on; red: permanently off)
- Water tank water level indicator (blue bar, width based on current level)

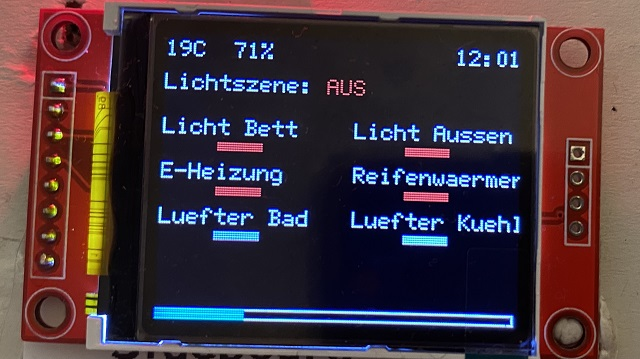
[picture p49: docs/mobile_smart_home_diy_camper_screen_01_default.jpg]
Default Screen


#### Water ingress status Screen Implementation

The water ingress status screen acts as monitoring for the installed water sensors. 
In case of the configured water ingress threshold is exceeded the related area name (where water sensor is installed) is tinted in red otherwise in green.

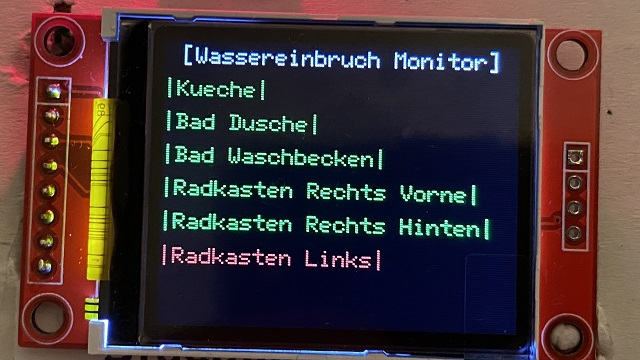
[picture p50: docs/mobile_smart_home_diy_camper_screen_02_water_ingress_status.jpg]
Water ingress status Screen


#### Climate status Screen Implementation

The climate status screen acts as monitoring for the installed temperature and humidity sensors. 
In case of the humidity of a sensor is at least 65, the related humidity for that area is tinted in red otherwise in green.

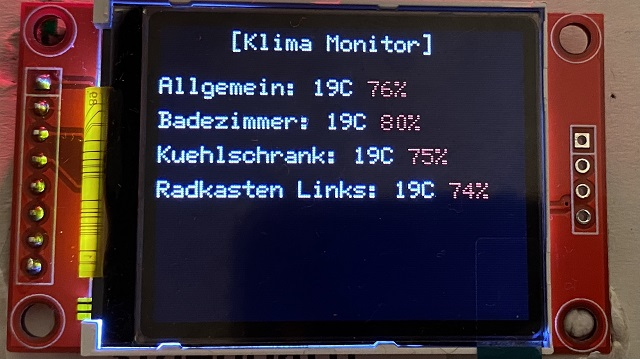
[picture p51: docs/mobile_smart_home_diy_camper_screen_03_climate_status.jpg]
Climate status Screen


#### Tire Warmers Timer Implementation

A timer can be set for the tire warmers, which are connected to RF sockets. 
Yes, that sounds crazy, but is soooo useful :-) 
Race events usually start early in the morning and with this feature the is no need to go out right after getting up and plug in your tire warmers.

Input is made via the keypad. There is also an input validation and a timer reset option.

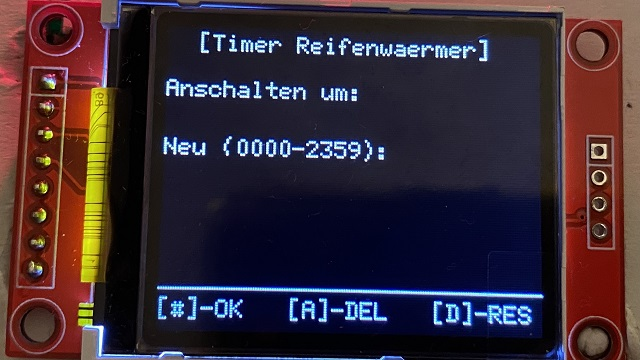
[picture p52: docs/mobile_smart_home_diy_camper_screen_04_tire_warmers_timer_1.jpg]
Tire Warmers Timer Screen 1

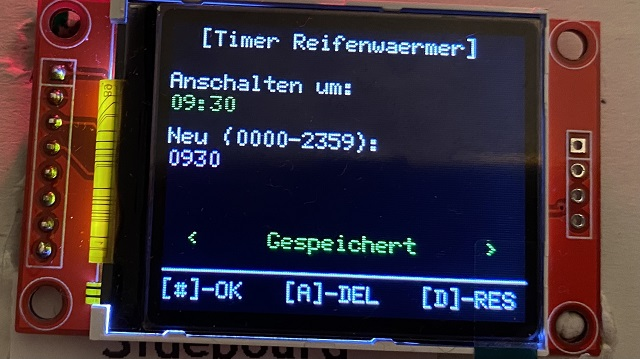
[picture p53: docs/mobile_smart_home_diy_camper_screen_04_tire_warmers_timer_2.jpg]
Tire Warmers Timer Screen 2


#### Time and Date Setting Implementation

The time and the date can be set. Input is made via the keypad. There is also an input validation.

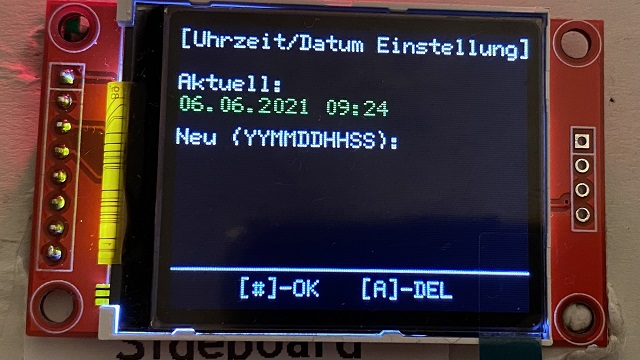
[picture p54: docs/mobile_smart_home_diy_camper_screen_05_time_date_setting.jpg]
Time and Date Setting Screen


#### System Settings Implementation

All important system setting are configurable. From this screen you can jump into each configuration area by using the related keypad button (1-8).

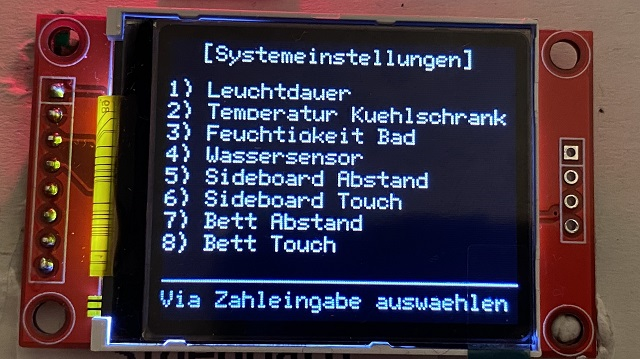
[picture p55: docs/mobile_smart_home_diy_camper_screen_06_system_settings_0_home.jpg]
System Settings Home Screen


##### Light Duration Configuration Implementation

The illumination duration of the TFT backlight and LEDs can be configured here.
Input is made via the keypad. There is also an input validation.

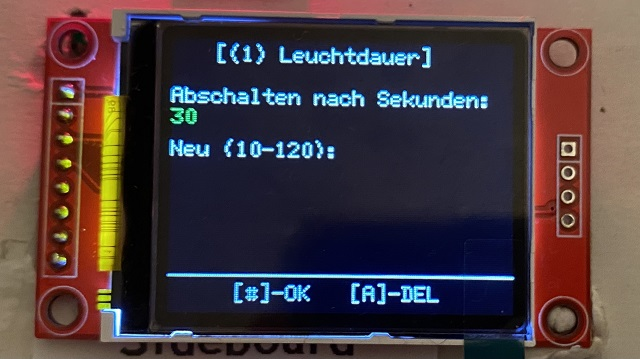
[picture p56: docs/mobile_smart_home_diy_camper_screen_06_system_settings_1_light_duration.jpg]
Light Duration Configuration Screen


##### Fridge Fan Temperature Threshold Configuration Implementation

The temperature threshold, when the fans located in fridge closet should turn on automatically (only in auto mode), can be configured here.

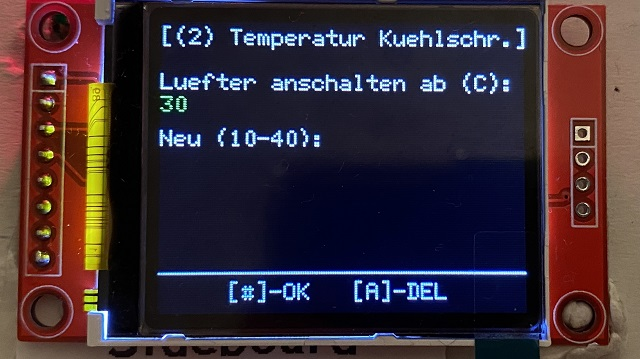
[picture p57: docs/mobile_smart_home_diy_camper_screen_06_system_settings_2_fan_temperature_fridge.jpg]
Fridge Fan Temperature Threshold Configuration Screen


##### Bathroom Fan Humidity Threshold Configuration Implementation

The humidity threshold, when the fan within the bathroom should turn on automatically (only in auto mode), can be configured here.

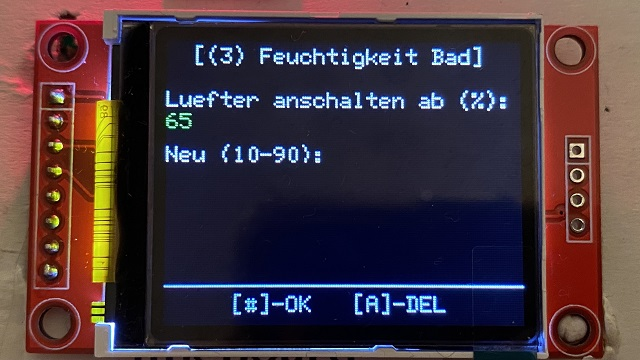
[picture p58: docs/mobile_smart_home_diy_camper_screen_06_system_settings_3_fan_humidity_bathroom.jpg]
Bathroom Fan Humidity Threshold Configuration Screen


##### Water Sensor Threshold Configuration Implementation

The water sensor threshold, that determines when water ingress should be reported.

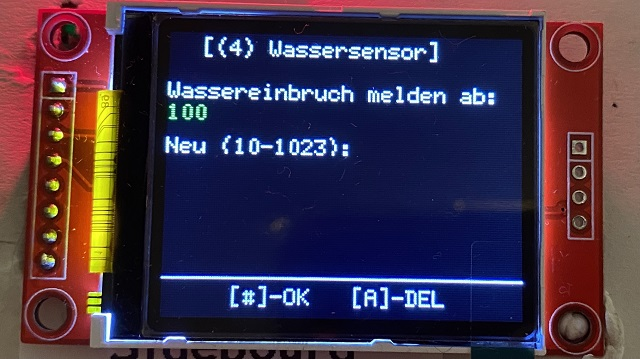
[picture p59: docs/mobile_smart_home_diy_camper_screen_06_system_settings_4_water_sensor.jpg]
Water Sensor Threshold Configuration Screen


##### Sideboard Distance Threshold Configuration Implementation

As Line Follower IR Sensor (TCRT5000) can be influenced by the incidence of light (depending on where the control unit is physically installed), you are able to configure the distance threshold of the sideboard control unit.

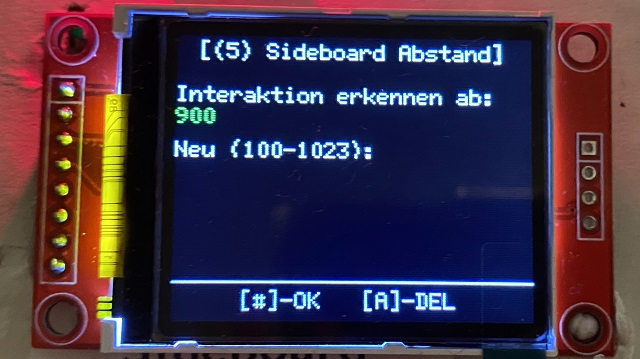
[picture p60: docs/mobile_smart_home_diy_camper_screen_06_system_settings_5_sideboard_distance.jpg]
Sideboard Distance Threshold Configuration Screen


##### Sideboard Touch Threshold Configuration Implementation

The sideboard touch threshold, that controls how sensitive the touch area at the sideboard control unit should react.

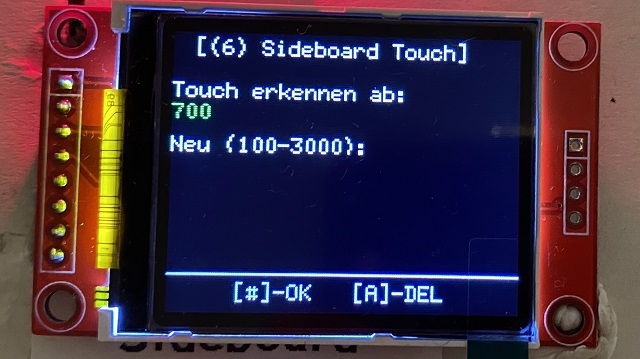
[picture p61: docs/mobile_smart_home_diy_camper_screen_06_system_settings_6_sideboard_touch.jpg]
Sideboard Touch Threshold Configuration Screen


##### Bed Distance Threshold Configuration Implementation

As Line Follower IR Sensor (TCRT5000) can be influenced by the incidence of light (depending on where the control unit is physically installed), you are able to configure the distance threshold of the bedroom control unit.

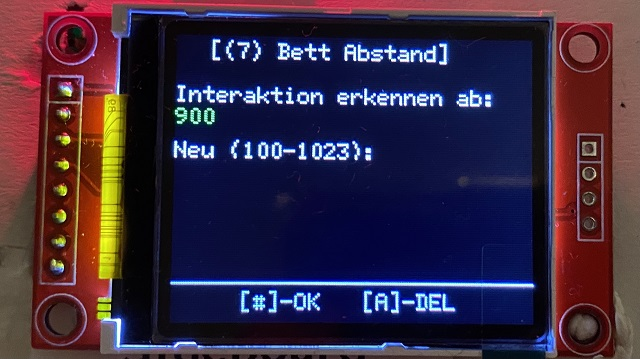
[picture p62: docs/mobile_smart_home_diy_camper_screen_06_system_settings_7_bed_distance.jpg]
Bed Distance Threshold Configuration Screen


##### Bed Touch Threshold Configuration Implementation

The bed touch threshold, that controls how sensitive the touch area at the bedroom control unit should react.

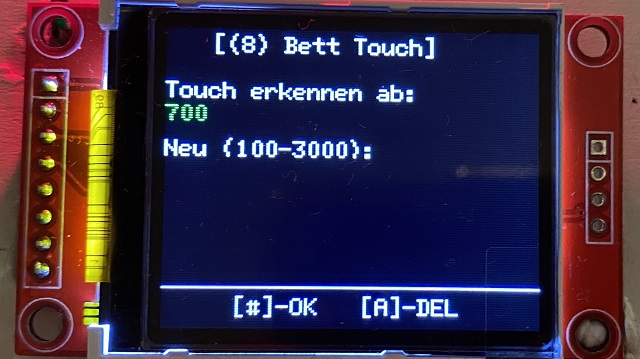
[picture p63: docs/mobile_smart_home_diy_camper_screen_06_system_settings_8_bed_touch.jpg]
Bed Touch Threshold Configuration Screen


## Lighting Control Concept

In order to use not all the different vendor specific IR remote controls to control our 230V lamps we use in our Sprinter, I've defined a lighting control concept. With only one button press, the related light scene is activated. In the background the previously recorded IR codes are sent by the different IR transmitter units. 

Each IR emitter unit can be requested separately. In our case this is very important, because three of the four lamps are from the same vendor (iDual) and their concept is that you can drive all iDual lamps with one IR remote control. 

The cool thing is here, that I can share the digital pin signal (in my case this is pin D9), which sends the IR signals, between all units. Meaning I can drive the five IR emitter units with one popular library for sending IR signals, as when I driving only one IR emitter.

As a result, I place the several IR transmitter units at the right place and ensure that I only activate the proper unit(s) to send IR codes, when needed.

In total I've build five IR transmitter units, but only four are for the lamps. The fifth one is for controlling the 230V electric heater.

The different supported light scenes as well as the separated control of the lamp within the bathroom are as follows:

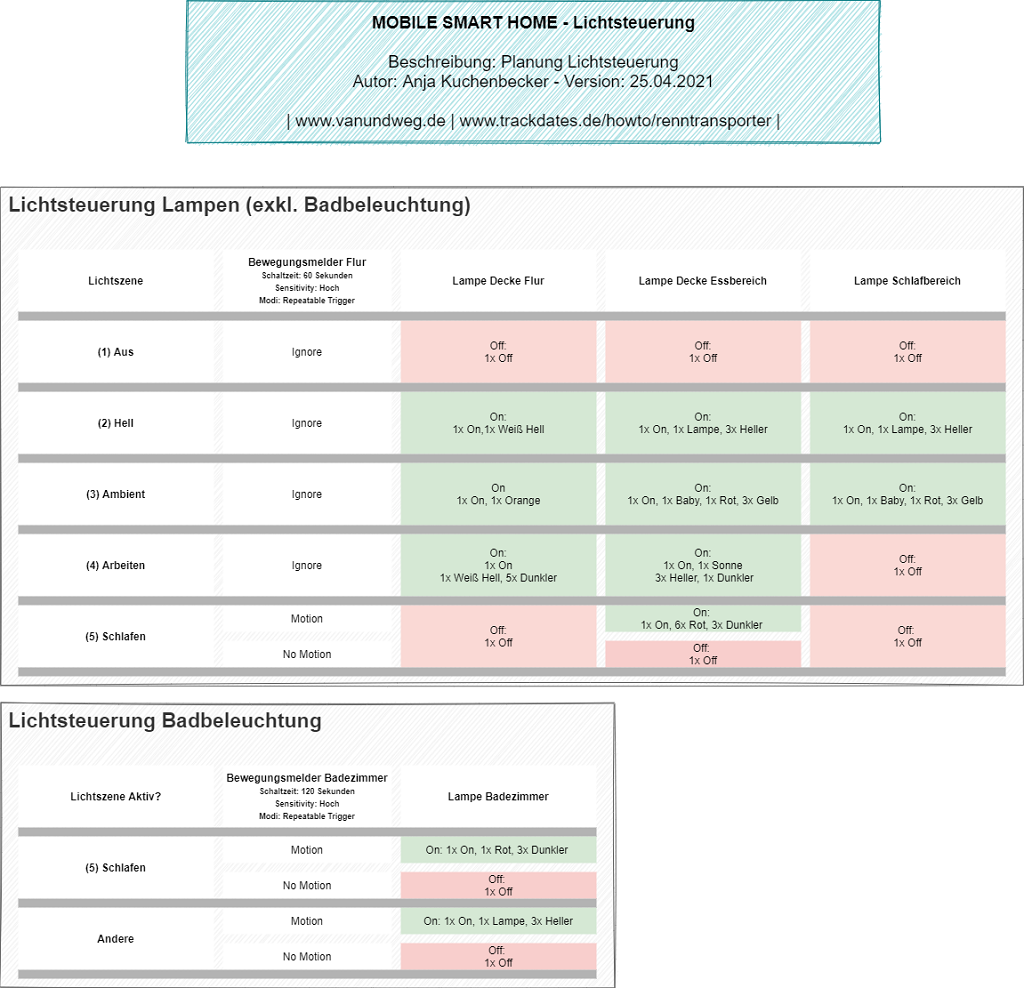
[picture p64: docs/mobile_smart_home_diy_camper_van_lighting_control.png]
Lighting Control


## Example Sketches

Within the [wiki](https://github.com/anjakuchenbecker/mobile_smart_home_diy_camper_van/wiki) you find some example sketches with respect to different topics, which are maybe useful for your purposes: 

- [Four Daisy Chained 74HC165 Shift Registers (Multiple Shift Registers)](https://github.com/anjakuchenbecker/mobile_smart_home_diy_camper_van/wiki/Four-Daisy-Chained-74HC165-Shift-Registers-(Multiple-Shift-Registers))
- [1.8 SPI TFT Display ST7735 128x160 pixel with programmatic backlight control](https://github.com/anjakuchenbecker/mobile_smart_home_diy_camper_van/wiki/1.8-SPI-TFT-Display-ST7735-128x160-pixel-with-programmatic-backlight-control)
- [Drive multiple IR emitters (TSAL 6200 IR 940 nm)](https://github.com/anjakuchenbecker/mobile_smart_home_diy_camper_van/wiki/Drive-multiple-IR-emitters-(TSAL-6200-IR-940-nm))

## Usage of the following software libs

Thanks to these guys:
- *ucglib* by Oli Kraus for TFT Display integration: https://github.com/olikraus/ucglib
- *Capacitive Sensing Library* by Paul Badger for touch area integration: https://github.com/PaulStoffregen/CapacitiveSensor
- *IRremote* by shirriff, z3t0, Armin Joachimsmeyer for IR communication integration: https://github.com/Arduino-IRremote/Arduino-IRremote
- *Keypad Library* for Arduino by Mark Stanley, Alexander Brevig for keypad integration: https://playground.arduino.cc/Code/Keypad/
- *DHT sensor library* by adafruit for DHT22 temperature and humidity sensor integration: https://github.com/adafruit/DHT-sensor-library
- *rc-switch* by sui77 for H34A RF 433 Mhz Transmitter integration: https://github.com/sui77/rc-switch
- *RTClib* by adafruit for DS3231 Real Time Clock (RTC) integration: https://github.com/adafruit/RTClib
- *Wire library* for external EEPROM (AT24C256 I2C Interface EEPROM) integration: https://www.arduino.cc/en/Reference/Wire
