anjakuchenbecker/mobile_smart_home_diy_camper_van/docs/mobile_smart_home_diy_camper_van_example_sketch_connection_diagram_four_daisy-chained_74HC165_shift_registers.png

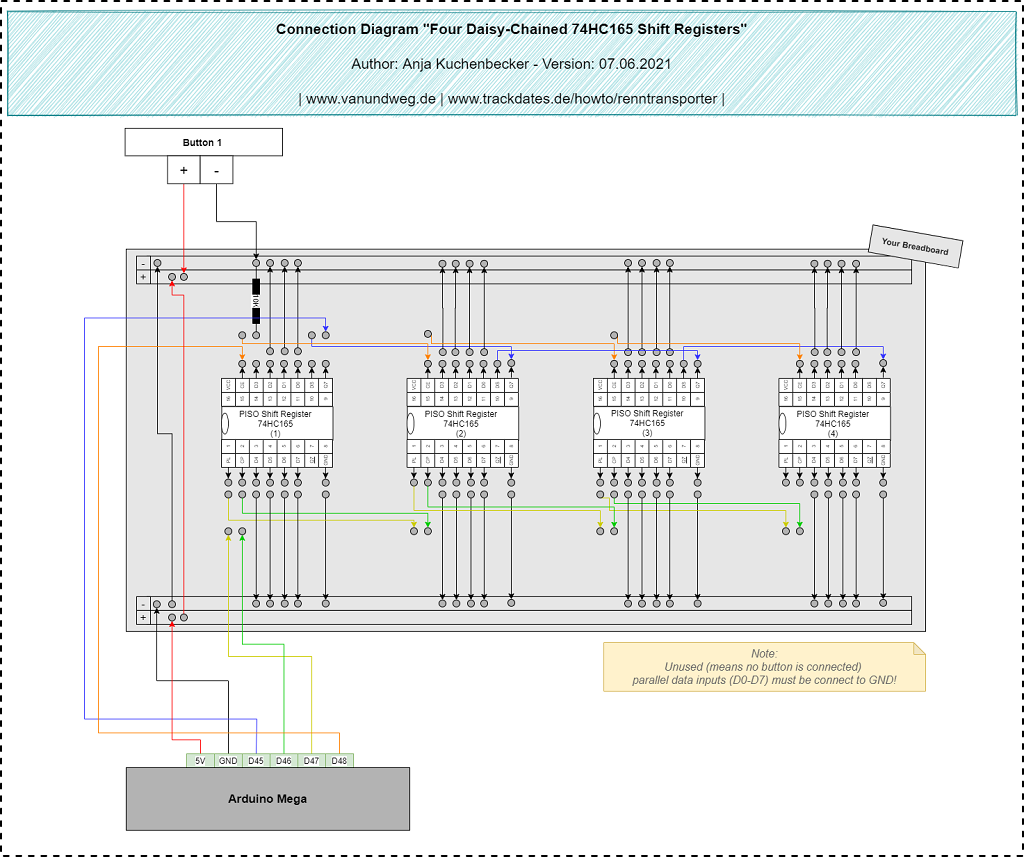
docs/mobile_smart_home_diy_camper_van_example_sketch_connection_diagram_four_daisy-chained_74HC165_shift_registers.png
