anjakuchenbecker/mobile_smart_home_diy_camper_van/docs/mobile_smart_home_diy_camper_van_example_sketch_connection_diagram_multiple_ir_emitters_tsal_6200ir_940_nm.png

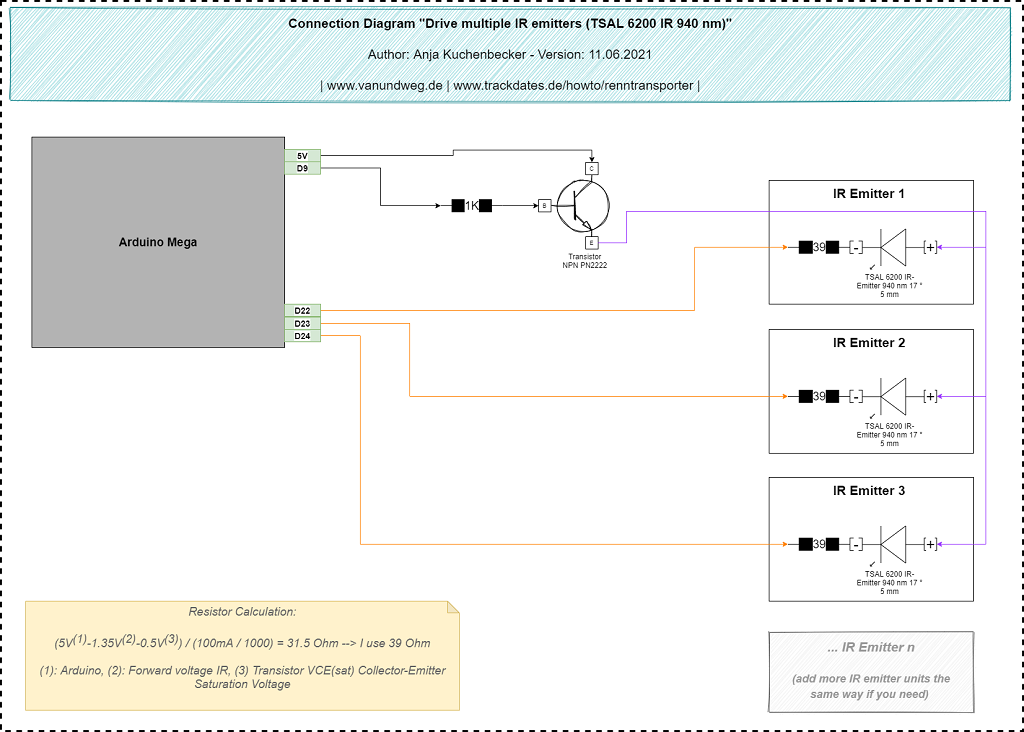
docs/mobile_smart_home_diy_camper_van_example_sketch_connection_diagram_multiple_ir_emitters_tsal_6200ir_940_nm.png
