anjakuchenbecker/mobile_smart_home_diy_camper_van/docs/mobile_smart_home_diy_camper_van_example_sketch_connection_diagram_TFT-Display-SPI-ST7735-128x160_backlight_control.png

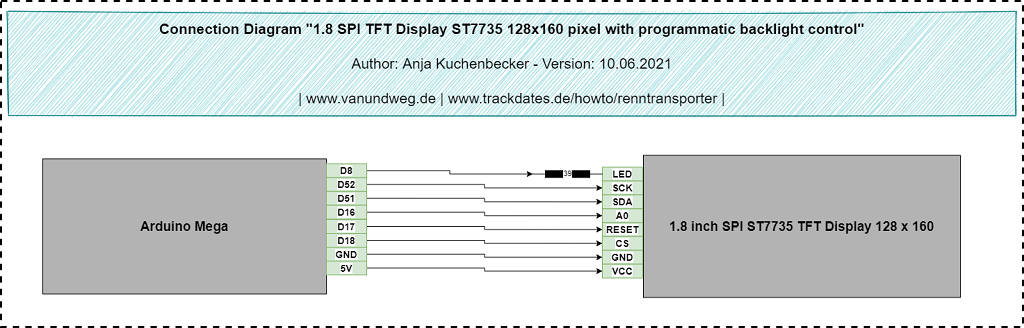
docs/mobile_smart_home_diy_camper_van_example_sketch_connection_diagram_TFT-Display-SPI-ST7735-128x160_backlight_control.png
