anjakuchenbecker/mobile_smart_home_diy_camper_van/example_sketches/TFT-Display-SPI-ST7735-128x160_backlight_control/TFT-Display-SPI-ST7735-128x160_backlight_control.ino

/**************************************************************************************
Example sketch that illustrates the driving of a 1.8 inch SPI ST7735 TFT Display 128 x 160 Pixel.
In scope is also the programmatic activation and deactivation of the TFT backlight.

Inspired by https://github.com/olikraus/ucglib/wiki/connectst7735
I'm using the following display: https://www.az-delivery.de/products/1-8-zoll-spi-tft-display

********************************************

Copyright © 2021 Anja Kuchenbecker

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
THE SOFTWARE IS PROVIDED "AS IS", WITHOUT WARRANTY OF ANY KIND,
EXPRESS OR IMPLIED, INCLUDING BUT NOT LIMITED TO THE WARRANTIES OF
MERCHANTABILITY, FITNESS FOR A PARTICULAR PURPOSE AND
NONINFRINGEMENT. IN NO EVENT SHALL THE AUTHORS OR COPYRIGHT HOLDERS BE
LIABLE FOR ANY CLAIM, DAMAGES OR OTHER LIABILITY, WHETHER IN AN ACTION
OF CONTRACT, TORT OR OTHERWISE, ARISING FROM, OUT OF OR IN CONNECTION
WITH THE SOFTWARE OR THE USE OR OTHER DEALINGS IN THE SOFTWARE.
****************************************************************************************/
// Includes
#include "Ucglib.h" 

// TFT pin definitions
// Note: SCK/SCL pin (D52) and SDA/MOSI pin (D51) on arduino mega must be not extra defined here when using hardware spi constructor (see below)
#define TFT_CD_PIN 16 // A0 on display --> TODO: Replace with your digital pin selection
#define TFT_CS_PIN 18 // CS on display --> TODO: Replace with your digital pin selection
#define TFT_RESET_PIN 17 // RESET on display --> TODO: Replace with your digital pin selection
#define TFT_BACKLIGHT_CONTROL_PIN 8 // "LED" pin on display --> TODO: Replace with your digital pin selection. Add a 39 Ohm resistor to reduce from 5v to 3.3v (100 Ohm is also OK, bigger resistor -> darker display). 

// TFT Constructor (hardware SPI usage --> HWSPI)
Ucglib_ST7735_18x128x160_HWSPI ucg(/*cd=*/ TFT_CD_PIN, /*cs=*/ TFT_CS_PIN, /*reset=*/ TFT_RESET_PIN);

void setup() {
  
  // Set pin mode for pin that controls the backlight of the TFT display
  pinMode(TFT_BACKLIGHT_CONTROL_PIN, OUTPUT);

  // Setup display: set font mode, clear, rotate
  ucg.begin(UCG_FONT_MODE_SOLID);
  ucg.clearScreen();
  ucg.setRotate90();
  
  // Print some stuff on the display
  // Note: printing within loop is very slow. Print static content only once in setup() and update dynamic content within loop() only when necessary.
  ucg.setFont(ucg_font_6x12_mf);
  ucg.setColor(0,255, 0, 0);
  ucg.setPrintPos(10,30);
  ucg.print("Hello World ;-)");
  
}

void loop() {

  // Turn backlight off
  digitalWrite(TFT_BACKLIGHT_CONTROL_PIN,HIGH);

  // Wait some time to see the backlight switch
  delay(2000);
  
  // Turn backlight on
  digitalWrite(TFT_BACKLIGHT_CONTROL_PIN,LOW);

  // Wait some time to see the backlight switch
  delay(2000);

}
